oscourse-tsinghua/OS2018spring-projects-g05/doc/out-of-dated/项目总结.pdf

## Tsinghua University

## Computer Organization Experimentation

# Project Summary Document

Author:
Shizhi Tang
Xihang Liu
Zixi Cai

Supervisor:
Yuxiang Zhang
Prof. Weidong Liu

January 21, 2018

## Contents

1 前⾔ | 3
2 迭代开发计划 | 3
3 分⼯ | 4
4 项⽬感想和总结 | 6

## 1 前⾔

本⽂档作为 BnG 组 32-bits MIPS CPU 的项⽬总结。对整个迭代开发的流程和我们在 其中得到的经验进⾏总结。

## 2 迭代开发计划

### 2.1 计划内容

我们组的迭代开发计划如下：

- Sprint 1 代码格式的约定，操作系统解读，分析初步的需求进⽽编写初步的需求⽂ 档，流⽔线通路和基本测试环境的搭建。
- Sprint 2 对应于《⾃⼰动⼿写 CPU》这本书中前 11 章的内容，完成 datapath 和异 常处理的⼯作。
- Sprint 3 串⼜控制器、Flash 访问模块，能够在硬件测试中通过功能测例。
- Sprint 4 能够在硬件上通过监控程序和 u-core。
- Sprint 5 完成 USB、以太⽹、HDMI 的外设⼯作。
- Sprint 6 完成除法等操作，最终可以运⾏ u-boot。

其中需要说明的是，前四个 Sprint 是项⽬的基本要求。⽽第五个和第六个 Sprint 则是 因为我们的进度较好，因此将需求从“能够正常运⾏ ucore”更改为“能够正常运⾏全部的 外设和通过 u-boot 启动 u-core”。可以看到，在这⼀过程⾥，需求是动态变动的。与其他组 不同的是，我们组的特点是：

- ⾸先对项⽬的需求进⾏了分析，并对代码格式和报告的格式进⾏了约定。
- 测试环境的搭建先于代码的编写，我们认为，这也是我们组能够在最后进度最快的重 要原因。
- 硬件测试为多个⼈同时进⾏，⼀⽅⾯是由于代码编译很慢，两个⼈可以在同⼀时间⾥ 验证更多的假设，另⼀⽅⾯，多个⼈ debug 也可以显著提⾼完成硬件测试的速度。

在整个项⽬的进⾏过程中，我们最注重的是测试的充分性。对每⼀个新加⼊的功能， 都需要加⼊对应的单元测试。此外，我们在设计测试框架时，也特别注意了“可以在之后 加⼊新功能之后，通过测例对功能进⾏充分的验证”。基于这⼀思想，我们也对功能测例进 ⾏了定制化。定制化之后的功能测例甚⾄可以直接在 Vivado 的仿真上运⾏，这也避免了实 现所需要花费的巨⼤时间成本，提⾼了 debug 的速度。

### 2.2 计划制定

在⼀开始拿到项⽬之后，我们并没有划分对应的 Sprint。在学期初，我们对 CPU 的整 个运⾏也⼗分不了解。但是我们组每隔⼀周都会开⼀次会，开会的主要内容包含两个⽅⾯：

- 分配下⼀周的任务，在每⼀次开会结束之后，我们会在 gitlab 上发布三个 issue，这 三个 issue 分别对应我们组三名同学在下⼀周所需要完成的⼯作。
- 讨论整个 CPU 中各种难点的设计，如访存时的状态机等。CPU 相关代码的编写⼯ 作，在整个项⽬所占的只是⾮常⼩的⼀部分，⽽合理的设计对项⽬的进⾏有着⾮常好 的帮助，好的架构可以让我们进展更快。此外，通过讨论，我们也可以将单⼈设计犯 错的可能性降低。

在第⼀次⼩组会议上，我们主要完成了代码格式的约定，之后分⼯，由蔡⼦熙同学负 责基本流⽔线的搭建。唐适之同学负责测试环境的搭建，⽽刘熙航则负责需求的分析和初 步需求报告的撰写。在这⼀阶段结束之后，我们⾸先按照《⾃⼰动⼿写 CPU》这本书的章 节顺序进⾏任务的分配（每周三章左右的进度，⼀名同学负责⼀章）。虽然这⼀任务在很多 时候并不能做到完全的并⾏开发，但是这是由于项⽬的特点所致。个⼈认为，我们在并⾏ 上做的是很好的。在按照《⾃⼰动⼿写 CPU》的章节⽬录进⾏项⽬的过程中，我们对整个 项⽬的进度有了更为清晰的认识。因此也就制定了前⽂中的 Sprint 2, 3, 4。按照这样的划 分，Sprint 1 虽然任务量较少，但其对于项⽬的进⾏有着⾄关重要的作⽤。有了好的测试 环境，我们就可以更好的进⾏开发。
由此也可以看到，在项⽬的⼀开始，我们是知道最终⽬标的。但是对于如何达成这⼀ 最终⽬标的认识⼗分不明确。⽽随着项⽬的进⾏，我们对最终⽬标的认识⼀步步的加深。 并在这⼀过程中对项⽬的 Sprint 进⾏了划分。由此我们也意识到，很多任务和我们搭建 mips-32 cpu 都有相似之处：在项⽬的⼀开始，最终的⽬标虽然很明确，但是具体的需求是 模糊的，⽽随着项⽬的进⾏，我们才能完全的明⽩项⽬最终的需求，并按照项⽬的需求进 ⾏变动。在这⼀任务的完成中，敏捷开发的思想是⼗分重要的。只有有了敏捷开发的思想。 我们才能够做得很好。

## 3 分⼯

### 3.1 Sprint 1

对于 Sprint 1，我们的分⼯为：

- 三个⼈⼀起编写代码的⽤例规范。
- 蔡⼦熙负责搭建基本的数据通路。
- 唐适之负责搭建基本的测试框架。
- 刘熙航负责分析需求，撰写初步的需求报告。

### 3.2 Sprint 2

在这⼀部分，分⼯为：

- 蔡⼦熙负责实现了移动指令和算数指令。
- 唐适之负责实现加载存储，并对代码进⾏相关的优化。
- 刘熙航负责实现了逻辑、移位、转移、CP0 和异常指令。

### 3.3 Sprint 3

在这⼀部分，分⼯为：

- 蔡⼦熙负责了串⼜控制器，搭建了功能侧例的仿真框架，并负责了⼀部分功能测例的 仿真通过。
- 唐适之负责实现了 MMU 和 TLB，并在硬件上跑通了全部的功能测例。
- 刘熙航负责对代码进⾏调试，并在仿真中通过了全部的功能测例。

### 3.4 Sprint 4

在这⼀部分，分⼯为：

- 蔡⼦熙和唐适之完成了监控程序的硬件通过。
- 刘熙航和唐适之完成了 u-core 在硬件上的通过（⾄此，基本要求已经完成，我们的 扩展要求分成外设和跑通 u-boot 两部分并⾏完成，即 Sprint5 和 Sprint6 是平⾏关 系）。

### 3.5 Sprint 5

这⼀部分由蔡⼦熙完成。

### 3.6 Sprint 6

这⼀部分的分⼯为：

- 蔡⼦熙实现了除法指令，并在硬件上跑通了全部的功能测例。
- 唐适之同学实现了额外的访存指令，并负责了 u-boot 相关的⼀些 debug。
- 刘熙航同学实现了与 cp0 相关的额外指令。

3.7 ⽂档

这⼀部分的分⼯为：唐适之负责设计⽂档，蔡⼦熙负责测试⽂档，刘熙航负责完善之 前的需求⽂档，并补充项⽬的总结⽂档。

## 4 项⽬感想和总结

我们的项⽬获得了巨⼤的成功，在计原最终展⽰时，我们组是所有的组⾥唯⼀⼀组跑通 u-boot 和全部功能测例的组，并且也实现了全部的可能实现的外设，可以说，我们完美的完 成了学期初的需求。以下，我们将项⽬开发中的⼀些经验和对项⽬的感想、建议总结如下：

### 4.1 项⽬总结

我们将在项⽬中收获的经验和整个开发流程的感受总结如下： 虽然在前期，我们组的进度与其他组很接近，但是到了后期，从跑通监控程序开始， 我们组的进度就已经领先了所有其他组。不得不说，整个实验的环境也有⼀些坑，这些 坑中的很多也都是要靠我们组慢慢的填平。如功能测例中的两个 bug:访存破坏⾃⾝数据 区、将 Cache 指令作为 reserved instruction，包括 u-core 会在不会被执⾏到的函数中使⽤ break 和 div 这两条指令，这些问题也都是我们组第⼀个遇到的。可以说，我们在这些坑上 花费了很多时间，但这些时间也是这个项⽬的⼀部分。就⼯作量⽽⾔，我们认为，⾃⼰的 32 位 CPU 并不⽐ 16 位的 CPU 复杂，需要的可能仅仅是将三周的时间平摊到⼀个学期， ⼤多数时间的⼯作量也反⽽会更少。所以，32 位 CPU 的实验，虽然有⼀些待完善的地⽅， 但也是⾮常值得去选的。
关于测试：
我们的测试分成三个阶段：在⼀开始，采⽤我们⾃⾏编写的测试框架进⾏单元测试， 之后通过功能测例进⾏集成测试，然后通过监控程序进⾏测试和 debug，之后通过 ucore 和 uboot 进⾏ debug。实际上，监控程序、ucore、uboot 除了需要⽀持的指令和机制有少 许的差别外，更⼤的难度来⾃于代码的规模。因为很多的 bug 会在⼀些概率极低的情况出 现（如我们曾经发现，sw 在 jalr 后三条时会出 bug，这就是⼀个很⼩概率的事件，但是却 直到 uboot 阶段才触发）。
测试⼀定要尽量早做，尽量全⾯地去做，我们的测试分为单元测试和集成测试两个部 分，集成测试又分为软件和硬件。在跑 u-core 时，我们耗时最长的⼀个 bug 花费了⼤约 70 个⼩时才被解决，⽽原因是在单元测试时，由于测试过于复杂⽽忽视了 ASID 段的相关内 容。在完成这个项⽬的过程⾥，我们真真切切感受到了，debug 的难度和项⽬的复杂程度 成指数级的关系。所以，单元测试⼀定要尽量全⾯的覆盖所有情况。这样可以为后期减少 很多的⿇烦。
在不同的测试阶段，应当关注不同的问题，在单元测试时，我们只需要去观察对应的 单元执⾏结果是否正确，⽽对于集成测试，我们更关注的是多条语句的结合。在硬件测试 时，问题往往是由访存等耗时较长的操作产⽣的，⽽在最终跑 u-core 和 u-boot 的阶段，⼤ 多数的 bug 都是和 cp0 相关的机制导致的，这些机制之前很难通过单元测试和功能测例找 到。特别是，很多情况下 bug 的发⽣会有条件，⽐如我们之前曾经发现，sw 在 jalr 之后三

条的位置会出错。这些也很难通过集成测试来查找。
我们认为，功能测例并不⾜以算是集成测试，其更偏向于单元测试（这是因为其测试 的重点在于指令是否按照期望被执⾏，⽽不是能通过指令的组合起到某些效果）。因为对于 硬件⽽⾔，集成测试的环境其实是很难编写的，其难度可能⽐ debug 还⾼，所以我们并没 有花时间去编写相应的框架。
关于设计：
虽然我们的编程是基于 VHDL 和 Verilog HDL 的，这也意味着和传统的设计模式没有 ⼤的关联，但是设计仍然很重要。这⾥所指的设计是整个流⽔线通路的设计。例如，在 《⾃⼰动⼿写 CPU》这本书中，其异常所采⽤的⽅法是⼀个向量的每⼀个 bit 代表⼀种异 常。⽽我们就将其修改为了⼀个 5bit 的数据来记录异常。这些与 mips 标准不太符合的修 改，是基于整个项⽬的特征所进⾏的。因此，对需求进⾏更全⾯、更充分的分析，可以让 我们在设计通路时少⾛很多弯路，进⽽达到提⾼效率的⽬的
关于分⼯：
⼤多数时候，我们的项⽬是串⾏⼯作的，这也是项⽬的性质所致：流⽔线通路的搭建， 往往是⼀个功能需要建⽴在前⼀个功能已经完整实现的基础之上。针对这⼀情况，我们采 ⽤了以下⼏种⽅式来缓解这⼀问题：
- 我们将每个⼈每周的空余时间分开，例如 A 在周三到周五完成功能 A，B 在周六开 始完成依赖于功能 A 的功能 B，以此类推。
- 在硬件测试时，由多个⼈同时找 bug，通过交流来提⾼效率。

### 4.2 项⽬感想

32 位 mips CPU 的项⽬，可以让我们更熟悉计算机的相关知识，熟悉 c++ 编译器可 能⽣成的所有指令的⼯作原理。虽然我们以后可能不会在 mips 架构上⼯作，但是熟悉底层 仍然可以帮助我们写出更好、更快的代码。⽽这些，也正是我们作为计算机科班学⽣的核 ⼼竞争⼒所在。⽽且，32 位的 CPU，让我们对底层的架构有了更为清晰的认知。 在下⼀学期⾥，我们将继续这⼀项⽬，与操作系统课联合，希望可以在 2018 年 9 ⽉龙 芯的⽐赛⾥取得好成绩。

### 4.3 对学弟学妹们的建议

我们的建议有以下⼏点：

- 要让团队中的每个成员都熟悉别⼈做的事情，熟悉所需要⽤到的全部⼯具链。
- 要尽早开始对项⽬进⾏测试。
- 开发流程中，要约定代码规范，实现功能时要考虑到后续被扩展的可能。
- 在项⽬中的⼀些难点上，要多与队友进⾏讨论。

BnG, better and greater.
