oscourse-tsinghua/OS2018spring-projects-g05/(threads)

Thread 3 (2018-03-31):

确认下述指令的实际含义，并实现

roastduck, 2018-03-31:
通过`mipsel-linux-gnu-objdump -d vmlinux | less`可以发现下述未能辨别的指令。请手动翻译机器码，确认其实际对应的指令，并实现

```
bc0t
bc0fl
c0
ehb
jr.hb
cfc0
ldc3
negu
sdc3
```

XemboLiu, 2018-04-03:
最新版本的指令集见：https://www.mips.com/?do-download=the-mips32-instruction-set-v6-06

bc0t：未能找到满足高12位可能是0x410的指令
bc0fl：未能找到满足高12位可能是0x410的指令
c0 0x4：这条指令实际上是 TLBINVF
ehb：有这条指令
jr.hb：有这条指令
cfc0 mfhc0：直接返回0即可（注：release6之前未定义，release6的文档中要求其将相应的寄存器置0）
ldc3：没有找到”110111”开头的指令
negu：实际上是特殊的subu指令
sdc3：未找到二进制为”111111”开头的指令

Thread 5 (2018-03-31):

编译使用软浮点数的Linux

roastduck, 2018-03-31:
Linux选项中`MATH_EMULATION`不适用于MIPS，但`mipsel-linux-gnu-`交叉编译器可以通过`-msoft-float`的方法编译软浮点数。请确认Linux是否有其他方式打开软浮点数，或修改Linux的Makefile以编译软浮点数。

roastduck, 2018-04-01:
根据[这篇文章](https://www.linux-mips.org/wiki/Floating_point)所述，不需要专门编译使用软浮点数的Linux。Linux会根据unimplemented异常自动处理。

Closed 2018-04-01.

Thread 6 (2018-04-01):

注意：Vivado综合器/仿真器在处理process(all)时可能忽略某些复杂类型的敏感信号

roastduck, 2018-04-01:
```
-- Probe entry
-- Here might be some bugs with the synthesisier, which failed to work with `process(all)`
process (entries, entry_i) begin
    index_o <= 4x"0";
    indexValid_o <= '0';
    for i in 0 to TLB_ENTRY_NUM - 1 loop
        if (entries(i).hi(EntryHiVPN2Bits) = entry_i.hi(EntryHiVPN2Bits)) then
            if (
                (entries(i).lo0(ENTRY_LO_G_BIT) and entries(i).lo1(ENTRY_LO_G_BIT)) = '1' or -- global
                entries(i).hi(EntryHiASIDBits) = entry_i.hi(EntryHiASIDBits) -- ASID match
            ) then
                index_o <= conv_std_logic_vector(i, 4);
                indexValid_o <= '1';
            end if;
        end if;
    end loop;
end process;
```

以上代码无法使用`process(all)`正常工作。

Thread 17 (2018-04-13):

关于Vivado Implement阶段卡死的注意事项

roastduck, 2018-04-13:
如果发现Vivado运行到某一阶段一直不能结束，但CPU利用率很低，很可能相关进程已经死了，这可以在log里确认。如果出现这种情况，可以考虑更改Implement策略。各策略的介绍见[文档UG904](https://www.xilinx.com/support/documentation/sw_manuals/xilinx2016_1/ug904-vivado-implementation.pdf)的附录C

roastduck, 2018-04-14:
如果怀疑遇到了时序冲突（例如遇到了随机错误），应选用优化更好的Synthesis/Implement策略

Thread 22 (2018-05-06):

项目中存在时序约束违例

roastduck, 2018-05-06:
现在从输入的100MHz的时钟生成25MHz的时钟，相位偏移了67°，最大的slack还有零点几纳秒，并且还可能有25MHz时钟域信号建立时间不足的隐患。

违例出现在`ddr3_ctrl`中，最严重的路径是从`busy_res`到`stat25`的。由于`stat25`是状态寄存器，所以不知道要怎么修改。不过，目的地是`readData_o`或`busy_o`的跨时钟域路径不必在意，因为它们实际上一个半周期算完就行，而不是半个周期。

roastduck, 2018-05-27:
此违例在DDR3测试中存在，但在主SoC中不存在。

Closed 2018-05-27.

Thread 53 (2018-09-12):

与FPU有关的TODO

XemboLiu, 2018-09-12:
add.d
bc1f
bc1t
c.eq.d
c.lt.d
c.ule.d
c.un.d
div.d
mov.d
mul.d
mul.s
sqrt.d
trunc.w.d

XemboLiu, 2018-09-12:
sub.d

XemboLiu, 2018-09-12:
总计三类：
- bc1f, bc1t与c.cond.fmt六条指令，类似于ll和sc的关系
- add.d sub.d mul.d/ mul.s div.d sqrt.d 六条计算指令
- trunc.w.d mov.d处理浮点寄存器，可以视为较为简单的计算指令
主体工作ddl暂定为周六
