oscourse-tsinghua/OS2018spring-projects-g05/myCPU/top.vhd

library ieee;
use ieee.std_logic_1164.all;
use work.global_const.all;
use work.bus_const.all;

entity top is
    generic (
        FUNC_TEST, MONITOR, USE_BOOTLOADER, ENABLE_CPU2: integer -- Only integer is supported in top level
    );
    port (
        clk_in: in std_logic; -- 100MHz clock input
        rst_n: in std_logic; -- Reset

        led_n: out std_logic_vector(15 downto 0); -- Single color LED
        led_rg0, led_rg1: out std_logic_vector(1 downto 0); -- Dual color LED

        num_cs_n: out std_logic_vector(7 downto 0); -- 7-seg enable
        num_a_g: out std_logic_vector(6 downto 0); -- 7-seg data

        switch: in std_logic_vector(7 downto 0); -- Switches. Push up for 0 and pull down for 1
        btn_key_col, btn_key_row: in std_logic_vector(3 downto 0); -- Keypad
        btn_step: in std_logic_vector(1 downto 0); -- Pulse button

        -- SPI flash EN25F80
        spi_clk: out std_logic; -- clock
        spi_cs_n: out std_logic; -- enable
        spi_di: out std_logic; -- data CPU -> flash
        spi_do: in std_logic; -- data flash -> CPU

        -- Ethernet DM9161AEP
        eth_txclk: in std_logic; -- Transmit reference clock
        eth_rxclk: in std_logic; -- Receive reference clock
        eth_txen: out std_logic; -- Transmit enable
        eth_txd: out std_logic_vector(3 downto 0); -- Transmit data
        eth_txerr: out std_logic; -- Transmit error
        eth_rxdv: in std_logic; -- Receive valid
        eth_rxd: in std_logic_vector(3 downto 0); -- Receive data
        eth_rxerr: in std_logic; -- Receive error
        eth_coll: in std_logic; -- Collision
        eth_crs: in std_logic; -- Carrier sence detect
        eth_mdc: out std_logic; -- Management data clock
        eth_mdio: inout std_logic; -- Management data I/O
        eth_rst_n: out std_logic; -- Reset

        -- UART
        uart_rx: in std_logic; -- Receive
        uart_tx: out std_logic; -- Transmit

        -- DDR3
        ddr3_dq: inout std_logic_vector(15 downto 0);
        ddr3_addr: out std_logic_vector(12 downto 0);
        ddr3_ba: out std_logic_vector(2 downto 0);
        ddr3_ras_n: out std_logic;
        ddr3_cas_n: out std_logic;
        ddr3_we_n: out std_logic;
        ddr3_odt: out std_logic;
        ddr3_reset_n: out std_logic;
        ddr3_cke: out std_logic;
        ddr3_dm: out std_logic_vector(1 downto 0);
        ddr3_dqs_p: inout std_logic_vector(1 downto 0);
        ddr3_dqs_n: inout std_logic_vector(1 downto 0);
        ddr3_ck_p: out std_logic;
        ddr3_ck_n: out std_logic
    );
end top;

architecture bhv of top is
    function getExceptBootBaseAddr return std_logic_vector is begin
        if (FUNC_TEST = 1 or MONITOR = 1) then
            return 32ux"80000000";
        else
            return 32ux"bfc00200";
        end if;
    end getExceptBootBaseAddr;
    function getTlbRefillExl0Offset return std_logic_vector is begin
        if (FUNC_TEST = 1) then
            return 32ux"180";
        elsif (MONITOR = 1) then
            return 32ux"1000";
        else
            return 32ux"000";
        end if;
    end getTlbRefillExl0Offset;
    function getGeneralExceptOffset return std_logic_vector is begin
        if (MONITOR = 1) then
            return 32ux"1180";
        else
            return 32ux"180";
        end if;
    end getGeneralExceptOffset;
    function getInstEntranceAddr return std_logic_vector is begin
        if (USE_BOOTLOADER = 1) then
            return 32ux"bfc00000";
        else
            return 32ux"80000000";
        end if;
    end getInstEntranceAddr;
    function cpu2On return std_logic is begin
        if (ENABLE_CPU2 = 1) then
            return '1';
        else
            return '0';
        end if;
    end cpu2On;

    -- Verilog entities must be declared
    component clk_wiz
        port (
            clk_in1: in std_logic;
            clk_out1, clk_out2, clk_out3: out std_logic
        );
    end component;
    component async_transmitter
        generic (
            ClkFrequency, Baud: integer
        );
        port (
            clk, TxD_start: in std_logic;
            TxD_data: in std_logic_vector(7 downto 0);
            TxD, TxD_busy: out std_logic
        );
    end component;
    component async_receiver
        generic (
            ClkFrequency, Baud: integer;
            Oversampling: integer := 8
        );
        port (
            clk, RxD: in std_logic;
            RxD_data_ready: out std_logic;
            RxD_data: out std_logic_vector(7 downto 0);
            RxD_idle, RxD_endofpacket: out std_logic
        );
    end component;

    signal rst: std_logic;

    signal clkMain: std_logic; -- 25MHz clock
    signal clk200, clk100: std_logic;

    signal cpu1Inst_c2d, cpu1Data_c2d, cpu2Inst_c2d, cpu2Data_c2d: BusC2D;
    signal cpu1Inst_d2c, cpu1Data_d2c, cpu2Inst_d2c, cpu2Data_d2c: BusD2C;
    signal ddr3_c2d, flash_c2d, serial_c2d, boot_c2d, eth_c2d, led_c2d, num_c2d, ipi_c2d, intc_c2d: BusC2D;
    signal ddr3_d2c, flash_d2c, serial_d2c, boot_d2c, eth_d2c, led_d2c, num_d2c, ipi_d2c, intc_d2c: BusD2C;

    signal busMon: BusC2D;
    signal llBit: std_logic;
    signal llLoc: std_logic_vector(AddrWidth);

    signal scCorrect1, scCorrect2: std_logic;
    signal sync1, sync2: std_logic_vector(2 downto 0);
    signal irq1, irq2: std_logic_vector(5 downto 0);
    signal timerInt1, timerInt2, comInt, usbInt, ethInt, ethIrq: std_logic;
    signal ipiInt: std_logic_vector(1 downto 0);

    -- Serial COM
    signal rxdReady, txdBusy, txdStart: std_logic;
    signal rxdData, txdData: std_logic_vector(7 downto 0);

    -- Ethernet
    signal eth_mdio_i, eth_mdio_o, eth_mdio_t: std_logic;

    -- LED
    signal ledHold: std_logic_vector(15 downto 0);
begin
    rst <= not rst_n;

    clk_wiz_ist: clk_wiz
        port map (
            clk_in1 => clk_in,
            clk_out1 => clk200,
            clk_out2 => clkMain,
            clk_out3 => clk100
        );

    uart_r: async_receiver
        generic map (
            ClkFrequency => 25000000,
            Baud => 9600
        )
        port map (
            clk => clkMain,
            RxD => uart_rx,
            RxD_data_ready => rxdReady,
            RxD_data => rxdData
        );
    uart_t: async_transmitter
        generic map (
            ClkFrequency => 25000000,
            Baud => 9600
        )
        port map (
            clk => clkMain,
            TxD => uart_tx,
            TxD_busy => txdBusy,
            TxD_start => txdStart,
            TxD_data => txdData
        );

    irq1 <= (5 => timerInt1, 4 => ipiInt(0), 3 => ethInt, 2 => comInt, others => '0');
    irq2 <= (5 => timerInt2, 4 => ipiInt(1), 3 => ethInt, 2 => comInt, others => '0');
    -- MIPS standard requires irq[5] = timer
    -- Monitor requires irq[2] = COM
    -- The IRQ ID should be consistent with the .dts file in Linux

    cpu1_ist: entity work.cpu
        generic map (
            memPushForward => true, -- TODO: Why???
            exceptBootBaseAddr => getExceptBootBaseAddr,
            tlbRefillExl0Offset => getTlbRefillExl0Offset,
            generalExceptOffset => getGeneralExceptOffset,
            instEntranceAddr => getInstEntranceAddr,
            cpuId => (0 => CPU1_ID, others => '0'),
            scStallPeriods => 0
        )
        port map (
            clk => clkMain,
            rst => rst,
            instDev_i => cpu1Inst_d2c,
            dataDev_i => cpu1Data_d2c,
            instDev_o => cpu1Inst_c2d,
            dataDev_o => cpu1Data_c2d,
            busMon_i => busMon,
            llBit_i => llBit,
            llLoc_i => llLoc,
            sync_o => sync1,
            scCorrect_i => scCorrect1,
            int_i => irq1,
            timerInt_o => timerInt1,
            debug_wb_pc => open,
            debug_wb_rf_wen => open,
            debug_wb_rf_wnum => open,
            debug_wb_rf_wdata => open
        );

    cpu2_ist: entity work.cpu
        generic map (
            memPushForward => true,
            exceptBootBaseAddr => getExceptBootBaseAddr,
            tlbRefillExl0Offset => getTlbRefillExl0Offset,
            generalExceptOffset => getGeneralExceptOffset,
            instEntranceAddr => getInstEntranceAddr,
            cpuId => (0 => CPU2_ID, others => '0'),
            scStallPeriods => 63
        )
        port map (
            clk => clkMain,
            rst => rst or not cpu2On,
            instDev_i => cpu2Inst_d2c,
            dataDev_i => cpu2Data_d2c,
            instDev_o => cpu2Inst_c2d,
            dataDev_o => cpu2Data_c2d,
            busMon_i => busMon,
            llBit_i => llBit,
            llLoc_i => llLoc,
            sync_o => sync2,
            scCorrect_i => scCorrect2,
            int_i => irq2,
            timerInt_o => timerInt2,
            debug_wb_pc => open,
            debug_wb_rf_wen => open,
            debug_wb_rf_wnum => open,
            debug_wb_rf_wdata => open
        );

    devctrl_ist: entity work.devctrl
        port map (
            clk => clkMain,
            rst => rst,

            cpu1Inst_i => cpu1Inst_c2d,
            cpu1Data_i => cpu1Data_c2d,
            cpu1Inst_o => cpu1Inst_d2c,
            cpu1Data_o => cpu1Data_d2c,
            cpu2Inst_i => cpu2Inst_c2d,
            cpu2Data_i => cpu2Data_c2d,
            cpu2Inst_o => cpu2Inst_d2c,
            cpu2Data_o => cpu2Data_d2c,

            ddr3_i => ddr3_d2c,
            flash_i => flash_d2c,
            serial_i => serial_d2c,
            boot_i => boot_d2c,
            eth_i => eth_d2c,
            led_i => led_d2c,
            num_i => num_d2c,
            ipi_i => ipi_d2c,
            intc_i => intc_d2c,
            ddr3_o => ddr3_c2d,
            flash_o => flash_c2d,
            serial_o => serial_c2d,
            boot_o => boot_c2d,
            eth_o => eth_c2d,
            led_o => led_c2d,
            num_o => num_c2d,
            ipi_o => ipi_c2d,
            intc_o => intc_c2d,

            busMon_o => busMon,
            llBit_o => llBit,
            llLoc_o => llLoc,

            sync1_i => sync1,
            scCorrect1_o => scCorrect1,
            sync2_i => sync2,
            scCorrect2_o => scCorrect2
    );

    -- Please don't pass tri-state ports into a sub-module

    flash_ctrl_ist: entity work.flash_ctrl
        port map (
            clk => clkMain,
            rst => rst,
            cpu_i => flash_c2d,
            cpu_o => flash_d2c,
            clk_o => spi_clk,
            cs_n_o => spi_cs_n,
            di_o => spi_di,
            do_i => spi_do
        );

    ddr3_ctrl_encap_ist: entity work.ddr3_ctrl_encap
        port map (
            clk_100 => clk100,
            clk_200 => clk200,
            clk_25 => clkMain,
            rst => rst,

            cpu_i => ddr3_c2d,
            cpu_o => ddr3_d2c,

            ddr3_dq => ddr3_dq,
            ddr3_addr => ddr3_addr,
            ddr3_ba => ddr3_ba,
            ddr3_ras_n => ddr3_ras_n,
            ddr3_cas_n => ddr3_cas_n,
            ddr3_we_n => ddr3_we_n,
            ddr3_odt => ddr3_odt,
            ddr3_reset_n => ddr3_reset_n,
            ddr3_cke => ddr3_cke,
            ddr3_dm => ddr3_dm,
            ddr3_dqs_p => ddr3_dqs_p,
            ddr3_dqs_n => ddr3_dqs_n,
            ddr3_ck_p => ddr3_ck_p,
            ddr3_ck_n => ddr3_ck_n
        );

    serial_ctrl_ist: entity work.serial_ctrl
        port map (
            clk => clkMain,
            rst => rst,
            cpu_i => serial_c2d,
            cpu_o => serial_d2c,
            int_o => comInt,
            rxdReady_i => rxdReady,
            rxdData_i => rxdData,
            txdBusy_i => txdBusy,
            txdStart_o => txdStart,
            txdData_o => txdData
        );

    boot_ctrl_ist: entity work.boot_ctrl
        port map (
            cpu_i => boot_c2d,
            cpu_o => boot_d2c
        );

    eth_ctrl_encap_ist: entity work.eth_ctrl_encap
        port map (
            clk_100 => clk100,
            clk_25 => clkMain,
            rst => rst,

            cpu_i => eth_c2d,
            cpu_o => eth_d2c,

            eth_rst_n => eth_rst_n,
            eth_txclk => eth_txclk,
            eth_rxclk => eth_rxclk,
            eth_txen => eth_txen,
            eth_rxdv => eth_rxdv,
            eth_txerr => eth_txerr,
            eth_rxerr => eth_rxerr,
            eth_txd => eth_txd,
            eth_rxd => eth_rxd,
            eth_coll => eth_coll,
            eth_crs => eth_crs,
            eth_mdio_i => eth_mdio_i,
            eth_mdio_o => eth_mdio_o,
            eth_mdio_t => eth_mdio_t,
            eth_mdc => eth_mdc,
            int_o => ethIrq
        );
    eth_mdio <= 'Z' when eth_mdio_t = '1' else eth_mdio_o;
    eth_mdio_i <= eth_mdio;

    int_ctrl_encap_ist: entity work.int_ctrl_encap
        port map (
            clk_100 => clk100,
            clk_25 => clkMain,
            rst => rst,

            cpu_i => intc_c2d,
            cpu_o => intc_d2c,

            int_i => ethIrq,
            int_o => ethInt
        );

    seg7_ctrl_ist: entity work.seg7_ctrl
        port map (
            clk => clkMain,
            rst => rst,
            cpu_i => num_c2d,
            cpu_o => num_d2c,
            cs_n_o => num_cs_n,
            lights_o => num_a_g
        );

    led_d2c.busy <= PIPELINE_NONSTOP;
    led_d2c.dataLoad <= (others => 'X');
    led_n <= not ledHold;
    process (clkMain) begin
        if (rising_edge(clkMain)) then
            if (rst = '1') then
                ledHold <= (others => '0');
            elsif (led_c2d.enable = '1') then
                ledHold <= led_c2d.dataSave(15 downto 0);
            end if;
        end if;
    end process;

    ipi_ctrl_ist: entity work.ipi_ctrl
        port map (
            clk => clkMain,
            rst => rst,
            cpu_i => ipi_c2d,
            cpu_o => ipi_d2c,
            int_o => ipiInt
        );
end bhv;
