oscourse-tsinghua/OS2018spring-projects-g05/src/thinpad_top.v

`default_nettype none

module thinpad_top(/*autoport*/
//inout
         base_ram_data,
         ext_ram_data,
         flash_data,
         sl811_data,
         dm9k_data,
//output
         uart_rdn,
         uart_wrn,
         base_ram_addr,
         base_ram_be_n,
         base_ram_ce_n,
         base_ram_oe_n,
         base_ram_we_n,
         ext_ram_addr,
         ext_ram_be_n,
         ext_ram_ce_n,
         ext_ram_oe_n,
         ext_ram_we_n,
         txd,
         flash_a,
         flash_rp_n,
         flash_vpen,
         flash_oe_n,
         flash_ce_n,
         flash_byte_n,
         flash_we_n,
         sl811_a0,
         sl811_we_n,
         sl811_rd_n,
         sl811_cs_n,
         sl811_rst_n,
         sl811_dack,
         dm9k_cmd,
         dm9k_we_n,
         dm9k_rd_n,
         dm9k_cs_n,
         dm9k_rst_n,
         leds,
         video_pixel,
         video_hsync,
         video_vsync,
         video_clk,
         video_de,
//input
         clk_in,
         clk_uart_in,
         uart_dataready,
         uart_tbre,
         uart_tsre,
         rxd,
         sl811_int,
         sl811_drq,
         dm9k_int,
         dip_sw,
         touch_btn);


input wire clk_in; //50MHz main clock input
input wire clk_uart_in; //11.0592MHz clock for UART

//UART controller signals
output wire uart_rdn;
output wire uart_wrn;
input wire uart_dataready;
input wire uart_tbre;
input wire uart_tsre;

//Base memory signals, a.k.a. RAM1
inout wire[31:0] base_ram_data; // [7:0] also connected to CPLD
output wire[19:0] base_ram_addr;
output wire[3:0] base_ram_be_n;
output wire base_ram_ce_n;
output wire base_ram_oe_n;
output wire base_ram_we_n;
//assign base_ram_be_n=4'b0; // keep ByteEnable zero if you don't know what it is

//Extension memory signals
inout wire[31:0] ext_ram_data;
output wire[19:0] ext_ram_addr;
output wire[3:0] ext_ram_be_n;
output wire ext_ram_ce_n;
output wire ext_ram_oe_n;
output wire ext_ram_we_n;
//assign ext_ram_be_n=4'b0; // keep ByteEnable zero if you don't know what it is

//Ext serial port signals
output wire txd;
input wire rxd;

//Flash memory, JS28F640
output wire [22:0]flash_a;
output wire flash_rp_n;
output wire flash_vpen;
output wire flash_oe_n;
inout wire [15:0]flash_data;
output wire flash_ce_n;
output wire flash_byte_n;
output wire flash_we_n;

//SL811 USB controller signals
output wire sl811_a0;
inout wire[7:0] sl811_data;
output wire sl811_we_n;
output wire sl811_rd_n;
output wire sl811_cs_n;
output wire sl811_rst_n;
output wire sl811_dack;
input wire sl811_int;
input wire sl811_drq;

//DM9000 Ethernet controller signals
output wire dm9k_cmd;
inout wire[15:0] dm9k_data;
output wire dm9k_we_n;
output wire dm9k_rd_n;
output wire dm9k_cs_n;
output wire dm9k_rst_n;
input wire dm9k_int;

//LED, SegDisp, DIP SW, and BTN1~6
output wire[31:0] leds; // leds[31:16] is SegDisp, leds[15:0] is LEDs
input wire[31:0] dip_sw;
input wire[5:0] touch_btn;

//Video output
output wire[7:0] video_pixel;
output wire video_hsync;
output wire video_vsync;
output wire video_clk;
output wire video_de;

/* =========== END OF PORT DECLARATION ============= */

wire rst;
assign rst = touch_btn[5];

wire clk25; // 25MHz clock
clk_ctrl clk_ctrl_ist(
    .clk_in1(clk_in),
    .clk_out1(clk25)
);

// 7-Segment display decoder
reg[7:0] numberHold;
SEG7_LUT segL(.oSEG1({leds[23:22],leds[19:17],leds[20],leds[21],leds[16]}), .iDIG(numberHold[3:0]));
SEG7_LUT segH(.oSEG1({leds[31:30],leds[27:25],leds[28],leds[29],leds[24]}), .iDIG(numberHold[7:4]));

// LED
reg[15:0] ledHold;
assign leds[15:0] = ledHold;

// Serial COM
wire rxdReady, txdBusy, txdStart;
wire[7:0] rxdData, txdData;
async_receiver
    #(.ClkFrequency(25000000), .Baud(9600))
    uart_r(.clk(clk25), .RxD(rxd), .RxD_data_ready(rxdReady), .RxD_data(rxdData));
async_transmitter
    #(.ClkFrequency(25000000),.Baud(9600))
    uart_t(.clk(clk25), .TxD(txd), .TxD_busy(txdBusy), .TxD_start(txdStart), .TxD_data(txdData));

wire devEnable, devWrite, devBusy;
wire[31:0] dataSave, dataLoad, addr;
wire[3:0] byteSelect;
wire[5:0] int;
wire timerInt, comInt, usbInt, ethInt;
assign int = {timerInt, 1'b0, 1'b0, comInt, ethInt, usbInt};
// NOTE: 1'b0 cannot be written as 0
// MIPS standard requires int[5] = timer
// Monitor requires int[2] = COM

cpu #(
`ifdef FUNC_TEST
    .exceptBootBaseAddr(32'h80000000),
    .tlbRefillExl0Offset(32'h180),
`elsif MONITOR
    .exceptBootBaseAddr(32'h80000000),
    .tlbRefillExl0Offset(32'h1000),
    .generalExceptOffset(32'h1180),
`endif
`ifdef USE_BOOTLOADER
    .instEntranceAddr(32'hbfc00000)
`else
    .instEntranceAddr(32'h80000000)
`endif
) cpu_ist (
    .clk(clk25),
    .rst(rst),
    .devEnable_o(devEnable),
    .devWrite_o(devWrite),
    .devBusy_i(devBusy),
    .devDataSave_o(dataSave),
    .devDataLoad_i(dataLoad),
    .devPhysicalAddr_o(addr),
    .devByteSelect_o(byteSelect),
    .int_i(int),
    .timerInt_o(timerInt)
);

wire ram0Enable, ram0ReadEnable, ram0WriteBusy;
wire[31:0] ram0DataSave, ram0DataLoad;
wire ram1Enable, ram1ReadEnable, ram1WriteBusy;
wire[31:0] ram1DataSave, ram1DataLoad;

wire flashEnable, flashReadEnable, flashBusy;
wire[31:0] flashDataLoad;

wire vgaEnable, vgaWriteEnable;
wire[31:0] vgaWriteData;
assign video_clk = clk25;

wire ltcEnable, ltcReadEnable, ltcBusy;
wire[31:0] ltcDataLoad;

wire comEnable, comReadEnable;
wire[31:0] comDataSave, comDataLoad;

wire usbEnable, usbReadEnable, usbWriteEnable, usbBusy;
wire[31:0] usbReadData, usbWriteData;

wire ethEnable, ethReadEnable, ethWriteBusy;
wire[31:0] ethDataLoad, ethDataSave;

wire[31:0] bootDataLoad;

wire ledEnable, numEnable;
wire[15:0] ledData;
wire[7:0] numData;

devctrl devctrl_ist(
    .devEnable_i(devEnable),
    .devWrite_i(devWrite),
    .devBusy_o(devBusy),
    .devDataSave_i(dataSave),
    .devDataLoad_o(dataLoad),
    .devPhysicalAddr_i(addr),

    .ram0Enable_o(ram0Enable),
    .ram0ReadEnable_o(ram0ReadEnable),
    .ram0DataSave_o(ram0DataSave),
    .ram0DataLoad_i(ram0DataLoad),
    .ram0WriteBusy_i(ram0WriteBusy),
    .ram1Enable_o(ram1Enable),
    .ram1ReadEnable_o(ram1ReadEnable),
    .ram1DataSave_o(ram1DataSave),
    .ram1DataLoad_i(ram1DataLoad),
    .ram1WriteBusy_i(ram1WriteBusy),

    .flashEnable_o(flashEnable),
    .flashReadEnable_o(flashReadEnable),
    .flashDataLoad_i(flashDataLoad),
    .flashBusy_i(flashBusy),

    .vgaEnable_o(vgaEnable),
    .vgaWriteEnable_o(vgaWriteEnable),
    .vgaWriteData_o(vgaWriteData),

    .comEnable_o(comEnable),
    .comReadEnable_o(comReadEnable),
    .comDataSave_o(comDataSave),
    .comDataLoad_i(comDataLoad),

    .usbEnable_o(usbEnable),
    .usbReadEnable_o(usbReadEnable),
    .usbReadData_i(usbReadData),
    .usbWriteEnable_o(usbWriteEnable),
    .usbWriteData_o(usbWriteData),
    .usbBusy_i(usbBusy),

    .bootDataLoad_i(bootDataLoad),

    .ltcEnable_o(ltcEnable),
    .ltcReadEnable_o(ltcReadEnable),
    .ltcDataLoad_i(ltcDataLoad),
    .ltcBusy_i(ltcBusy),

    .ethEnable_o(ethEnable),
    .ethReadEnable_o(ethReadEnable),
    .ethDataLoad_i(ethDataLoad),
    .ethDataSave_o(ethDataSave),
    .ethWriteBusy_i(ethWriteBusy),

    .ledEnable_o(ledEnable),
    .ledData_o(ledData),
    .numEnable_o(numEnable),
    .numData_o(numData)
);

// Please don't pass inout port into a sub-module
wire ram0TriStateWrite;
sram_ctrl base_sram_ctrl(
    .clk(clk25),
    .rst(rst),
    .enable_i(ram0Enable),
    .readEnable_i(ram0ReadEnable),
    .addr_i(addr),
    .byteSelect_i(byteSelect),
    .busy_o(ram0WriteBusy),
    .triStateWrite_o(ram0TriStateWrite),
    .addr_o(base_ram_addr),
    .be_n_o(base_ram_be_n),
    .ce_n_o(base_ram_ce_n),
    .oe_n_o(base_ram_oe_n),
    .we_n_o(base_ram_we_n)
);
assign base_ram_data = ram0TriStateWrite ? ram0DataSave : 32'hzzzzzzzz;
assign ram0DataLoad = base_ram_data;

wire ram1TriStateWrite;
sram_ctrl ext_sram_ctrl(
    .clk(clk25),
    .rst(rst),
    .enable_i(ram1Enable),
    .readEnable_i(ram1ReadEnable),
    .addr_i(addr),
    .byteSelect_i(byteSelect),
    .busy_o(ram1WriteBusy),
    .triStateWrite_o(ram1TriStateWrite),
    .addr_o(ext_ram_addr),
    .be_n_o(ext_ram_be_n),
    .ce_n_o(ext_ram_ce_n),
    .oe_n_o(ext_ram_oe_n),
    .we_n_o(ext_ram_we_n)
);
assign ext_ram_data = ram1TriStateWrite ? ram1DataSave : 32'hzzzzzzzz;
assign ram1DataLoad = ext_ram_data;

flash_ctrl flash_ctrl_ist(
    .clk(clk25),
    .rst(rst),
    .devEnable_i(flashEnable),
    .addr_i(addr),
    .readEnable_i(flashReadEnable),
    .readData_o(flashDataLoad),
    .busy_o(flashBusy),
    .flRst_o(flash_rp_n),
    .flOE_o(flash_oe_n),
    .flCE_o(flash_ce_n),
    .flWE_o(flash_we_n),
    .flAddr_o(flash_a),
    .flData_i(flash_data),
    .flByte_o(flash_byte_n),
    .flVpen_o(flash_vpen)
);

vga_ctrl vga_ctrl_ist(
    .clk(clk25),
    .rst(rst),
    .devEnable_i(vgaEnable),
    .addr_i(addr),
    .writeEnable_i(vgaWriteEnable),
    .writeData_i(vgaWriteData),
    .writeByteSelect_i(byteSelect),
    .de_o(video_de),
    .rgb_o(video_pixel),
    .hs_o(video_hsync),
    .vs_o(video_vsync)
);

serial_ctrl serial_ctrl_ist(
    .clk(clk25),
    .rst(rst),
    .enable_i(comEnable),
    .readEnable_i(comReadEnable),
    .mode_i(addr[2]),
    .dataSave_i(comDataSave),
    .dataLoad_o(comDataLoad),
    .int_o(comInt),
    .rxdReady_i(rxdReady),
    .rxdData_i(rxdData),
    .txdBusy_i(txdBusy),
    .txdStart_o(txdStart),
    .txdData_o(txdData)
);

wire usbTriStateWrite;
usb_ctrl usb_ctrl_ist(
    .clk(clk25),
    .rst(rst),
    .devEnable_i(usbEnable),
    .addr_i(addr),
    .readEnable_i(usbReadEnable),
    .writeEnable_i(usbWriteEnable),
    .busy_o(usbBusy),
    .int_o(usbInt),
    .triStateWrite_o(usbTriStateWrite),
    .usbA0_o(sl811_a0),
    .usbWE_o(sl811_we_n),
    .usbRD_o(sl811_rd_n),
    .usbCS_o(sl811_cs_n),
    .usbRst_o(sl811_rst_n),
    .usbDACK_o(sl811_dack),
    .usbInt_i(sl811_int)
);
assign sl811_data = usbTriStateWrite ? usbWriteData[7:0] : 8'hzz;
assign usbReadData = {24'b0, sl811_data};

boot_ctrl boot_ctrl_ist(
    .addr_i(addr),
    .readData_o(bootDataLoad)
);

lattice_ram_ctrl lattice_ram_ctrl_ist(
    .clk(clk25),
    .rst(rst),
    .devEnable_i(ltcEnable),
    .readEnable_i(ltcReadEnable),
    .addr_i(addr),
    .readData_o(ltcDataLoad),
    .busy_o(ltcBusy)
);

wire ethTriStateWrite;
eth_ctrl eth_ctrl_ist(
    .clk(clk25),
    .rst(rst),
    .enable_i(ethEnable),
    .readEnable_i(ethReadEnable),
    .addr_i(addr),
    .writeBusy_o(ethWriteBusy),
    .int_o(ethInt),
    .triStateWrite_o(ethTriStateWrite),

    .ethInt_i(dm9k_int),
    .ethCmd_o(dm9k_cmd),
    .ethWE_o(dm9k_we_n),
    .ethRD_o(dm9k_rd_n),
    .ethCS_o(dm9k_cs_n),
    .ethRst_o(dm9k_rst_n)
);
assign dm9k_data = ethTriStateWrite ? ethDataSave[15:0] : 16'hzzzz;
assign ethDataLoad = {16'b0, dm9k_data};

always@(posedge clk25) begin
    if (rst == 1) begin
        ledHold <= 0;
        numberHold <= 0;
    end else begin
        if (ledEnable)
            ledHold <= ledData;
        if (numEnable)
            numberHold <= numData;
    end
end

/* sram_ctrl Test 1: Alternatively write and read
 * 1. Press and release rst
 * 2. LED should show 0xAAAA pattern
 */
/*
reg[15:0] count, correct, testDataSave;
reg reading;
assign addr = count;
assign ramEnable = 1;
assign ramReadEnable = reading;
assign byteSelect = 4'hf;
assign leds[15:0] = correct;
assign ramDataSave = {16'h0, testDataSave};
always@(posedge clk25) begin
    if (rst) begin
        count <= 0;
        correct <= 0;
        reading <= 0;
    end else begin
        if (count < 16'haaaa || reading == 0) begin
            if (reading == 0) begin
                testDataSave <= count;
            end else begin
                if (ramDataLoad[15:0] == count)
                    correct <= correct + 1;
                count <= count + 1;
            end
            reading <= ~reading;
        end
    end
end
*/

/* sram_ctrl Test 2: Load arbitary data
 * 1. Upload RAM initializing file
 * 2. Press and release reset
 * 3. Set the switches and watch the LEDs
 */
/*
assign ramEnable = 1;
assign ramReadEnable = 1;
assign byteSelect = 4'hf;
assign addr = dip_sw;
assign leds[15:0] = ramDataLoad[15:0];
*/

endmodule
