oscourse-tsinghua/OS2018spring-projects-g05/myCPU/dev/serial_ctrl.vhd

library ieee;
use ieee.std_logic_1164.all;
use work.global_const.all;
use work.bus_const.all;

entity serial_ctrl is
    port (
        clk, rst: in std_logic;

        cpu_i: in BusC2D; -- addr: 0xBFD003FC for status, 0xBFD003F8 for data
        cpu_o: out BusD2C;

        int_o: out std_logic; -- Interruption

        rxdReady_i: in std_logic;
        rxdData_i: in std_logic_vector(7 downto 0); -- rxdReady_i and rxdData_i only hold for 1 period
        txdBusy_i: in std_logic;
        txdStart_o: out std_logic;
        txdData_o: out std_logic_vector(7 downto 0)
    );
end serial_ctrl;

architecture bhv of serial_ctrl is
    signal recvAvail: std_logic;
    signal recvData: std_logic_vector(7 downto 0);
    signal txIRE, rxIRE: std_logic; -- Interrupt Enable
    constant TX_READY: integer := 0;
    constant RX_READY: integer := 1;
    constant TX_IRE: integer := 3;
    constant RX_IRE: integer := 4;
begin
    cpu_o.dataLoad <= (
            TX_READY => not txdBusy_i,
            RX_READY => rxdReady_i or recvAvail,
            TX_IRE => txIRE,
            RX_IRE => rxIRE,
            others => '0'
        ) when cpu_i.addr(2) = '1' else
            24ux"0" & rxdData_i when rxdReady_i = '1' else 24ux"0" & recvData;
    -- When recvAvail = NO or chip disabled, outputting whatever is OK

    cpu_o.busy <= PIPELINE_NONSTOP;

    int_o <= ((rxdReady_i or recvAvail) and rxIRE) or (not txdBusy_i and txIRE);

    process (clk) begin
        if (rising_edge(clk)) then
            txdStart_o <= '0';
            txdData_o <= (others => '0');
            if (rst = RST_ENABLE) then
                recvAvail <= NO;
                recvData <= (others => '0');
                txIRE <= NO;
                rxIRE <= YES;
            else
                if (rxdReady_i = '1') then
                    recvAvail <= YES;
                    recvData <= rxdData_i;
                end if;
                if (cpu_i.enable = ENABLE and cpu_i.write = NO and cpu_i.addr(2) = '0') then
                    recvAvail <= NO;
                    recvData <= (others => '0');
                end if;

                if (cpu_i.enable = ENABLE and cpu_i.write = YES) then
                    if (cpu_i.addr(2) = '1') then
                        txIRE <= cpu_i.dataSave(TX_IRE);
                        rxIRE <= cpu_i.dataSave(RX_IRE);
                    elsif (txdBusy_i = '0') then -- cpu_i.addr(2) = '0'
                        -- If busy, ignore it
                        txdStart_o <= '1';
                        txdData_o <= cpu_i.dataSave(7 downto 0);
                    end if;
                end if;
            end if;
        end if;
    end process;
end bhv;
