oscourse-tsinghua/OS2018spring-projects-g05/myCPU/datapath/ex.vhd

library ieee;
use ieee.std_logic_1164.all;
use ieee.std_logic_unsigned.all;
use ieee.numeric_std.all;
-- NOTE: std_logic_unsigned cannot be used at the same time with std_logic_signed
--       Use numeric_std if signed number is needed (different API)
use work.global_const.all;
use work.alu_const.all;
use work.mem_const.all;
use work.except_const.all;
use work.cp0_const.all;

entity ex is
    generic (
        extraCmd: boolean
    );
    port (
        alut_i: in AluType;
        memt_i: in MemType;
        operand1_i: in std_logic_vector(DataWidth);
        operand2_i: in std_logic_vector(DataWidth);
        operandX_i: in std_logic_vector(DataWidth);
        toWriteReg_i: in std_logic;
        writeRegAddr_i: in std_logic_vector(RegAddrWidth);
        linkAddress_i: in std_logic_vector(AddrWidth);
        isInDelaySlot_i: in std_logic;
        toStall_o: out std_logic;
        toWriteReg_o: out std_logic;
        writeRegAddr_o: out std_logic_vector(RegAddrWidth);
        writeRegData_o: out std_logic_vector(DataWidth);

        -- Hi Lo --
        hi_i, lo_i: in std_logic_vector(DataWidth);
        memToWriteHi_i, memToWriteLo_i: in std_logic;
        memWriteHiData_i, memWriteLoData_i: in std_logic_vector(DataWidth);
        wbToWriteHi_i, wbToWriteLo_i: in std_logic;
        wbWriteHiData_i, wbWriteLoData_i: in std_logic_vector(DataWidth);
        toWriteHi_o, toWriteLo_o: out std_logic;
        writeHiData_o, writeLoData_o: out std_logic_vector(DataWidth);

        -- Memory --
        memt_o: out MemType;
        memAddr_o: out std_logic_vector(AddrWidth);
        memData_o: out std_logic_vector(DataWidth);

        -- multi-period --
        tempProduct_i: in std_logic_vector(DoubleDataWidth);
        cnt_i: in std_logic_vector(CntWidth);
        tempProduct_o: out std_logic_vector(DoubleDataWidth);
        cnt_o: out std_logic_vector(CntWidth);

        -- interact with div --
        divBusy_i: in std_logic;
        quotient_i, remainder_i: in std_logic_vector(DataWidth);
        divEnable_o: out std_logic;
        dividend_o, divider_o: out std_logic_vector(DataWidth);

        -- interact with CP0 --
        cp0RegData_i: in std_logic_vector(DataWidth);
        cp0RegDataValid_i: in std_logic;
        memCP0RegData_i: in std_logic_vector(DataWidth);
        memCP0RegWriteAddr_i: in std_logic_vector(CP0RegAddrWidth);
        memCP0RegWe_i: in std_logic;
        cp0RegReadAddr_o: out std_logic_vector(CP0RegAddrWidth);
        cp0RegReadSel_o: out std_logic_vector(SelWidth);
        cp0RegData_o: out std_logic_vector(DataWidth);
        cp0RegWriteAddr_o: out std_logic_vector(CP0RegAddrWidth);
        cp0RegWriteSel_o: out std_logic_vector(SelWidth);
        cp0RegWe_o: out std_logic;
        cp0Sp_o: out CP0Special;

        -- for exception --
        valid_i: in std_logic;
        valid_o: out std_logic;
        noInt_i: in std_logic;
        noInt_o: out std_logic;
        exceptCause_i: in std_logic_vector(ExceptionCauseWidth);
        tlbRefill_i: in std_logic;
        currentInstAddr_i: in std_logic_vector(AddrWidth);
        exceptCause_o: out std_logic_vector(ExceptionCauseWidth);
        tlbRefill_o: out std_logic;
        isInDelaySlot_o: out std_logic;
        currentInstAddr_o: out std_logic_vector(AddrWidth);
        flushForceWrite_i: in std_logic;
        flushForceWrite_o: out std_logic
    );
end ex;

architecture bhv of ex is

    function complement(x: std_logic_vector(DataWidth)) return std_logic_vector is
    begin
        return (not x) + 1;
    end complement;

    function complement64(x: std_logic_vector(DoubleDataWidth)) return std_logic_vector is
    begin
        return (not x) + 1;
    end complement64;

    function addOverflow(x, y: std_logic_vector(DataWidth)) return boolean is
        variable res: std_logic_vector(DataWidth);
    begin
        res := x + y;
        return ((x(31)  or y(31)) = '0' and res(31) = '1') or
               ((x(31) and y(31)) = '1' and res(31) = '0');
    end addOverflow;

    function subOverflow(x, y: std_logic_vector(DataWidth)) return boolean is
        variable res: std_logic_vector(DataWidth);
    begin
        res := x - y;
        return (x(31) and not y(31) and not res(31)) = '1' or -- Negative - positive -> positive
               (not x(31) and y(31) and res(31)) = '1'; -- Positive - negative -> negative
    end subOverflow;

    signal realHiData, realLoData: std_logic_vector(DataWidth) := (others => '0');
    signal clo, clz: std_logic_vector(DataWidth);

    signal multip1, multip2: std_logic_vector(DataWidth);
    signal calcMult: std_logic := '0';
    signal product: std_logic_vector(DoubleDataWidth);
    signal trapAssert: std_logic;
    signal reg1Ltreg2: std_logic;
begin
    memt_o <= memt_i;
    flushForceWrite_o <= flushForceWrite_i;

    clo <= 32ux"00" when operand1_i(31) = '0' else 32ux"01" when operand1_i(30) = '0' else
           32ux"02" when operand1_i(29) = '0' else 32ux"03" when operand1_i(28) = '0' else
           32ux"04" when operand1_i(27) = '0' else 32ux"05" when operand1_i(26) = '0' else
           32ux"06" when operand1_i(25) = '0' else 32ux"07" when operand1_i(24) = '0' else
           32ux"08" when operand1_i(23) = '0' else 32ux"09" when operand1_i(22) = '0' else
           32ux"0a" when operand1_i(21) = '0' else 32ux"0b" when operand1_i(20) = '0' else
           32ux"0c" when operand1_i(19) = '0' else 32ux"0d" when operand1_i(18) = '0' else
           32ux"0e" when operand1_i(17) = '0' else 32ux"0f" when operand1_i(16) = '0' else
           32ux"10" when operand1_i(15) = '0' else 32ux"11" when operand1_i(14) = '0' else
           32ux"12" when operand1_i(13) = '0' else 32ux"13" when operand1_i(12) = '0' else
           32ux"14" when operand1_i(11) = '0' else 32ux"15" when operand1_i(10) = '0' else
           32ux"16" when operand1_i( 9) = '0' else 32ux"17" when operand1_i( 8) = '0' else
           32ux"18" when operand1_i( 7) = '0' else 32ux"19" when operand1_i( 6) = '0' else
           32ux"1a" when operand1_i( 5) = '0' else 32ux"1b" when operand1_i( 4) = '0' else
           32ux"1c" when operand1_i( 3) = '0' else 32ux"1d" when operand1_i( 2) = '0' else
           32ux"1e" when operand1_i( 1) = '0' else 32ux"1f" when operand1_i( 0) = '0' else
           32ux"20";
    clz <= 32ux"00" when operand1_i(31) = '1' else 32ux"01" when operand1_i(30) = '1' else
           32ux"02" when operand1_i(29) = '1' else 32ux"03" when operand1_i(28) = '1' else
           32ux"04" when operand1_i(27) = '1' else 32ux"05" when operand1_i(26) = '1' else
           32ux"06" when operand1_i(25) = '1' else 32ux"07" when operand1_i(24) = '1' else
           32ux"08" when operand1_i(23) = '1' else 32ux"09" when operand1_i(22) = '1' else
           32ux"0a" when operand1_i(21) = '1' else 32ux"0b" when operand1_i(20) = '1' else
           32ux"0c" when operand1_i(19) = '1' else 32ux"0d" when operand1_i(18) = '1' else
           32ux"0e" when operand1_i(17) = '1' else 32ux"0f" when operand1_i(16) = '1' else
           32ux"10" when operand1_i(15) = '1' else 32ux"11" when operand1_i(14) = '1' else
           32ux"12" when operand1_i(13) = '1' else 32ux"13" when operand1_i(12) = '1' else
           32ux"14" when operand1_i(11) = '1' else 32ux"15" when operand1_i(10) = '1' else
           32ux"16" when operand1_i( 9) = '1' else 32ux"17" when operand1_i( 8) = '1' else
           32ux"18" when operand1_i( 7) = '1' else 32ux"19" when operand1_i( 6) = '1' else
           32ux"1a" when operand1_i( 5) = '1' else 32ux"1b" when operand1_i( 4) = '1' else
           32ux"1c" when operand1_i( 3) = '1' else 32ux"1d" when operand1_i( 2) = '1' else
           32ux"1e" when operand1_i( 1) = '1' else 32ux"1f" when operand1_i( 0) = '1' else
           32ux"20";

    isInDelaySlot_o <= isInDelaySlot_i;
    currentInstAddr_o <= currentInstAddr_i;
    valid_o <= valid_i;
    noInt_o <= noInt_i;

    -- multiplication --
    process(multip1, multip2, alut_i, calcMult)
        variable m1, m2: std_logic_vector(DataWidth);
        variable ans: std_logic_vector(DoubleDataWidth);
        variable sgnMul: boolean;
        variable neg: boolean;
    begin
        if (alut_i = ALU_MULTU or (extraCmd and (alut_i = ALU_MADDU or alut_i = ALU_MSUBU))) then
            sgnMul := false;
        else
            sgnMul := true;
        end if;

        neg := false;
        if (calcMult = '1') then
            if (sgnMul and multip1(31) = '1') then
                m1 := complement(multip1);
                neg := not neg;
            else
                m1 := multip1;
            end if;
            if (sgnMul and multip2(31) = '1') then
                m2 := complement(multip2);
                neg := not neg;
            else
                m2 := multip2;
            end if;
        end if;

        ans := m1 * m2;
        if (neg) then
            product <= complement64(ans);
        else
            product <= ans;
        end if;
    end process;

    -- hi lo --
    process(all) begin
        realHiData <= hi_i;
        realLoData <= lo_i;
        if (wbToWriteHi_i = YES) then
            realHiData <= wbWriteHiData_i;
        end if;
        if (memToWriteHi_i = YES) then
            realHiData <= memWriteHiData_i;
        end if;
        if (wbToWriteLo_i = YES) then
            realLoData <= wbWriteLoData_i;
        end if;
        if (memToWriteLo_i = YES) then
            realLoData <= memWriteLoData_i;
        end if;
    end process;

    process(all)
        variable res: std_logic_vector(DataWidth);
        variable res64: std_logic_vector(DoubleDataWidth);
        variable ovSum: std_logic;
    begin
        toWriteHi_o <= NO;
        toWriteLo_o <= NO;
        toWriteReg_o <= toWriteReg_i;
        memAddr_o <= (others => '0');
        memData_o <= (others => '0');
        writeRegAddr_o <= writeRegAddr_i;
        writeRegData_o <= (others => '0');
        toStall_o <= PIPELINE_NONSTOP;
        calcMult <= '0';
        tempProduct_o <= (others => '0');
        cnt_o <= (others => '0');
        cp0RegWe_o <= NO;
        cp0RegWriteAddr_o <= (others => '0');
        cp0RegWriteSel_o <= (others => '0');
        cp0RegData_o <= (others => '0');
        cp0Sp_o <= INVALID;
        writeHiData_o <= (others => '0');
        writeLoData_o <= (others => '0');
        cp0RegReadAddr_o <= (others => '0');
        cp0RegReadSel_o <= (others => '0');
        divEnable_o <= DISABLE;
        dividend_o <= (others => '0');
        divider_o <= (others => '0');

        exceptCause_o <= exceptCause_i;
        tlbRefill_o <= tlbRefill_i;

        res64 := (others => 'X');
        ovSum := NO; -- Otherwise it will introduce a level latch to keep the prior value

        if (extraCmd) then
            case alut_i is
                when ALU_MOVN =>
                    if (operand2_i /= ZEROS_32) then
                        writeRegData_o <= operand1_i;
                    else
                        toWriteReg_o <= NO;
                        writeRegData_o <= (others => '0');
                    end if;

                when ALU_MOVZ =>
                    if (operand2_i = ZEROS_32) then
                        writeRegData_o <= operand1_i;
                    else
                        toWriteReg_o <= NO;
                        writeRegData_o <= (others => '0');
                    end if;

                when ALU_MADD | ALU_MADDU | ALU_MSUB | ALU_MSUBU =>
                    if (cnt_i = "00") then
                        calcMult <= '1';
                        multip1 <= operand1_i;
                        multip2 <= operand2_i;
                        tempProduct_o <= product;
                        cnt_o <= "01";
                        toStall_o <= PIPELINE_STOP;
                    elsif (cnt_i = "01") then
                        calcMult <= '0';
                        tempProduct_o <= (others => '0');
                        cnt_o <= "00";
                        toStall_o <= PIPELINE_NONSTOP;
                        toWriteHi_o <= YES;
                        toWriteLo_o <= YES;
                        if (alut_i = ALU_MADD or alut_i = ALU_MADDU) then
                            res64 := (realHiData & realLoData) + tempProduct_i;
                        elsif (alut_i = ALU_MSUB or alut_i = ALU_MSUBU) then
                            res64 := (realHiData & realLoData) - tempProduct_i;
                        end if;
                        writeHiData_o <= res64(HiDataWidth);
                        writeLoData_o <= res64(LoDataWidth);
                    end if;

                when ALU_TLBWI =>
                    cp0Sp_o <= CP0SP_TLBWI;

                when ALU_TLBWR =>
                    cp0Sp_o <= CP0SP_TLBWR;

                when ALU_TLBP =>
                    cp0Sp_o <= CP0SP_TLBP;

                when ALU_TLBR =>
                    cp0Sp_o <= CP0SP_TLBR;

                when ALU_TLBINVF =>
                    cp0Sp_o <= CP0SP_TLBINVF;

                when others =>
                    null;
            end case;
        end if;
        case alut_i is
            when ALU_OR => writeRegData_o <= operand1_i or operand2_i;
            when ALU_AND => writeRegData_o <= operand1_i and operand2_i;
            when ALU_XOR => writeRegData_o <= operand1_i xor operand2_i;
            when ALU_NOR => writeRegData_o <= operand1_i nor operand2_i;
            when ALU_SLL => writeRegData_o <= operand2_i sll to_integer(unsigned(operand1_i(4 downto 0)));
            when ALU_SRL => writeRegData_o <= operand2_i srl to_integer(unsigned(operand1_i(4 downto 0)));
            when ALU_SRA => writeRegData_o <= to_stdlogicvector(
                to_bitvector(operand2_i) sra to_integer(unsigned(operand1_i(4 downto 0)))
            );
            when ALU_LUI => writeRegData_o <= operand1_i(15 downto 0) & 16b"0";
            when ALU_JBAL => writeRegData_o <= linkAddress_i;

            when ALU_MFHI =>
                writeRegData_o <= realHiData;

            when ALU_MFLO =>
                writeRegData_o <= realLoData;

            when ALU_MFH =>
                writeRegAddr_o <= (others => '0');

            when ALU_MTHI =>
                toWriteHi_o <= YES;
                writeHiData_o <= operand1_i;

            when ALU_MTLO =>
                toWriteLo_o <= YES;
                writeLoData_o <= operand1_i;

            when ALU_LOAD =>
                memAddr_o <= to_stdlogicvector(operand1_i + to_integer(signed(operandX_i(15 downto 0))));

            when ALU_STORE =>
                memAddr_o <= to_stdlogicvector(operand1_i + to_integer(signed(operandX_i(15 downto 0))));
                memData_o <= operand2_i;

            when ALU_ADD =>
                if (addOverflow(operand1_i, operand2_i)) then
                    ovSum := YES;
                else
                    writeRegData_o <= operand1_i + operand2_i;
                end if;

            when ALU_ADDU =>
                writeRegData_o <= operand1_i + operand2_i;

            when ALU_SUB =>
                if (subOverflow(operand1_i, operand2_i)) then
                    ovSum := YES;
                else
                    writeRegData_o <= operand1_i - operand2_i;
                end if;

            when ALU_SUBU =>
                writeRegData_o <= operand1_i - operand2_i;

            when ALU_SLT =>
                res := operand1_i - operand2_i;
                if (not subOverflow(operand1_i, operand2_i)) then
                    writeRegData_o <= ZEROS_31 & res(31);
                else
                    writeRegData_o <= ZEROS_31 & (not res(31));
                end if;

            when ALU_SLTU =>
                if (operand1_i < operand2_i) then
                    writeRegData_o <= ZEROS_31 & '1';
                else
                    writeRegData_o <= ZEROS_31 & '0';
                end if;

            when ALU_CLO => writeRegData_o <= clo;

            when ALU_CLZ => writeRegData_o <= clz;

            when ALU_MUL =>
                calcMult <= '1';
                multip1 <= operand1_i;
                multip2 <= operand2_i;
                writeRegData_o <= product(LoDataWidth);

            when ALU_MULT =>
                calcMult <= '1';
                multip1 <= operand1_i;
                multip2 <= operand2_i;
                toWriteHi_o <= YES;
                writeHiData_o <= product(HiDataWidth);
                toWriteLo_o <= YES;
                writeLoData_o <= product(LoDataWidth);

            when ALU_MULTU =>
                calcMult <= '1';
                multip1 <= operand1_i;
                multip2 <= operand2_i;
                toWriteHi_o <= YES;
                writeHiData_o <= product(HiDataWidth);
                toWriteLo_o <= YES;
                writeLoData_o <= product(LoDataWidth);

            when ALU_DIV =>
                toWriteHi_o <= YES;
                toWriteLo_o <= YES;
                divEnable_o <= ENABLE;
                toStall_o <= divBusy_i;

                if (operand1_i(31) = '0') then
                    if (operand2_i(31) = '0') then
                        writeHiData_o <= remainder_i;
                        writeLoData_o <= quotient_i;
                        dividend_o <= operand1_i;
                        divider_o <= operand2_i;
                    else
                        writeHiData_o <= remainder_i;
                        writeLoData_o <= complement(quotient_i);
                        dividend_o <= operand1_i;
                        divider_o <= complement(operand2_i);
                    end if;
                else
                    if (operand2_i(31) = '0') then
                        writeHiData_o <= complement(remainder_i);
                        writeLoData_o <= complement(quotient_i);
                        dividend_o <= complement(operand1_i);
                        divider_o <= operand2_i;
                    else
                        writeHiData_o <= complement(remainder_i);
                        writeLoData_o <= quotient_i;
                        dividend_o <= complement(operand1_i);
                        divider_o <= complement(operand2_i);
                    end if;
                end if;

            when ALU_DIVU =>
                toWriteHi_o <= YES;
                writeHiData_o <= remainder_i;
                toWriteLo_o <= YES;
                writeLoData_o <= quotient_i;
                divEnable_o <= ENABLE;
                toStall_o <= divBusy_i;
                dividend_o <= operand1_i;
                divider_o <= operand2_i;

            when ALU_MFC0 =>
                cp0RegReadAddr_o <= operand1_i(4 downto 0);
                cp0RegReadSel_o <= operandX_i(SelWidth);
                writeRegData_o <= cp0RegData_i;
                if (cp0RegDataValid_i = NO) then
                    toStall_o <= PIPELINE_STOP;
                end if;

                -- Push forward for cp0 --
                if (memCP0RegWe_i = YES and memCP0RegWriteAddr_i = operand1_i(4 downto 0)) then
                    toStall_o <= PIPELINE_STOP;
                end if;

            when ALU_MTC0 =>
                cp0RegWriteAddr_o <= operand1_i(4 downto 0);
                cp0RegWriteSel_o <= operandX_i(SelWidth);
                cp0RegWe_o <= YES;
                cp0RegData_o <= operand2_i;

            when others =>
                null;
        end case;
        if ((alut_i = ALU_ADD) or (alut_i = ALU_SUB)) then
            if (ovSum = YES) then
                toWriteReg_o <= NO;
                exceptCause_o <= OVERFLOW_CAUSE;
            else
                toWriteReg_o <= YES;
            end if;
        end if;

        if (
            ((memt_i = MEM_LW or memt_i = MEM_SW) and memAddr_o(1 downto 0) /= "00") or
            ((memt_i = MEM_LH or memt_i = MEM_LHU or memt_i = MEM_SH) and memAddr_o(0) /= '0')
        ) then
            if (alut_i = ALU_LOAD) then
                exceptCause_o <= ADDR_ERR_LOAD_OR_IF_CAUSE;
            else
                exceptCause_o <= ADDR_ERR_STORE_CAUSE;
            end if;
        end if;
    end process;

end bhv;
