oscourse-tsinghua/OS2018spring-projects-g05/myCPU/const/inst_const.vhd

library ieee;
use ieee.std_logic_1164.all;

package inst_const is

    --
    -- Format of instructions, classified into R type, I type and J type
    --
    subtype InstOpIdx               is integer range 31 downto 26;
    subtype InstRsIdx               is integer range 25 downto 21;
    subtype InstRtIdx               is integer range 20 downto 16;
    subtype InstRdIdx               is integer range 15 downto 11;
    subtype InstSaIdx               is integer range 10 downto  6;
    subtype InstFuncIdx             is integer range  5 downto  0;
    subtype InstImmIdx              is integer range 15 downto  0;
    subtype InstUnsignedImmIdx      is integer range 14 downto  0;
    subtype InstImmSignIdx          is integer range 15 downto 15;
    subtype InstAddrIdx             is integer range 25 downto  0;
    subtype InstJmpUnchangeIdx      is integer range 31 downto 28;
    subtype InstImmAddrIdx          is integer range 25 downto  0;
    subtype InstSaFuncIdx           is integer range 10 downto  3;
    subtype InstSelIdx              is integer range  2 downto  0;

    subtype InstOpWidth             is integer range  5 downto  0;
    subtype InstRsWidth             is integer range  4 downto  0;
    subtype InstRtWidth             is integer range  4 downto  0;
    subtype InstRdWidth             is integer range  4 downto  0;
    subtype InstSaWidth             is integer range  4 downto  0;
    subtype InstFuncWidth           is integer range  5 downto  0;
    subtype InstImmWidth            is integer range 15 downto  0;
    subtype InstUnsignedImmWidth    is integer range 14 downto  0;
    subtype InstImmSignWidth        is integer range 15 downto 15;
    subtype InstAddrWidth           is integer range 25 downto  0;
    subtype InstJmpUnchangeWidth    is integer range  3 downto  0;
    subtype InstImmAddrWidth        is integer range 25 downto  0;
    subtype InstOffsetImmWidth      is integer range 17 downto  0;
    subtype InstSaFuncWidth         is integer range  7 downto  0;

    --
    -- Logic OP/FUNC codes
    --
    constant FUNC_AND: std_logic_vector(InstFuncWidth) := "100100";
    constant FUNC_OR: std_logic_vector(InstFuncWidth) := "100101";
    constant FUNC_XOR: std_logic_vector(InstFuncWidth) := "100110";
    constant FUNC_NOR: std_logic_vector(InstFuncWidth) := "100111";

    constant OP_ANDI: std_logic_vector(InstOpWidth) := "001100";
    constant OP_ORI: std_logic_vector(InstOpWidth) := "001101";
    constant OP_XORI: std_logic_vector(InstOpWidth) := "001110";
    constant OP_LUI: std_logic_vector(InstOpWidth) := "001111";
    constant OP_PREF: std_logic_vector(InstOpWidth) := "110011";

    --
    -- Algebraic FUNC codes
    --
    constant FUNC_SLL: std_logic_vector(InstFuncWidth) := "000000";
    constant FUNC_SLLV: std_logic_vector(InstFuncWidth) := "000100";
    constant FUNC_SRL: std_logic_vector(InstFuncWidth) := "000010";
    constant FUNC_SRLV: std_logic_vector(InstFuncWidth) := "000110";
    constant FUNC_SRA: std_logic_vector(InstFuncWidth) := "000011";
    constant FUNC_SRAV: std_logic_vector(InstFuncWidth) := "000111";

    --
    -- Move FUNC codes
    --
    constant FUNC_MOVN: std_logic_vector(InstFuncWidth) := "001011";
    constant FUNC_MOVZ: std_logic_vector(InstFuncWidth) := "001010";
    constant FUNC_MFHI: std_logic_vector(InstFuncWidth) := "010000";
    constant FUNC_MFLO: std_logic_vector(InstFuncWidth) := "010010";
    constant FUNC_MTHI: std_logic_vector(InstFuncWidth) := "010001";
    constant FUNC_MTLO: std_logic_vector(InstFuncWidth) := "010011";

    --
    -- TRAP
    --
    constant FUNC_TNE: std_logic_vector(InstFuncWidth) := "110110";

    --
    -- Memory OP codes
    --
    constant OP_LB: std_logic_vector(InstOpWidth) := "100000";
    constant OP_LBU: std_logic_vector(InstOpWidth) := "100100";
    constant OP_LH: std_logic_vector(InstOpWidth) := "100001";
    constant OP_LHU: std_logic_vector(InstOpWidth) := "100101";
    constant OP_LW: std_logic_vector(InstOpWidth) := "100011";
    constant OP_LWL: std_logic_vector(InstOpWidth) := "100010";
    constant OP_LWR: std_logic_vector(InstOpWidth) := "100110";
    constant OP_SB: std_logic_vector(InstOpWidth) := "101000";
    constant OP_SH: std_logic_vector(InstOpWidth) := "101001";
    constant OP_SW: std_logic_vector(InstOpWidth) := "101011";
    constant OP_SWL: std_logic_vector(InstOpWidth) := "101010";
    constant OP_SWR: std_logic_vector(InstOpWidth) := "101110";
    constant OP_LL: std_logic_vector(InstOpWidth) := "110000";
    constant OP_SC: std_logic_vector(InstOpWidth) := "111000";

    --
    -- Arith OP/FUNC codes
    --
    constant FUNC_ADD: std_logic_vector(InstFuncWidth) := "100000";
    constant FUNC_ADDU: std_logic_vector(InstFuncWidth) := "100001";
    constant FUNC_SUB: std_logic_vector(InstFuncWidth) := "100010";
    constant FUNC_SUBU: std_logic_vector(InstFuncWidth) := "100011";
    constant FUNC_SLT: std_logic_vector(InstFuncWidth) := "101010";
    constant FUNC_SLTU: std_logic_vector(InstFuncWidth) := "101011";
    constant FUNC_MULT: std_logic_vector(InstFuncWidth) := "011000";
    constant FUNC_MULTU: std_logic_vector(InstFuncWidth) := "011001";

    constant OP_ADDI: std_logic_vector(InstOpWidth) := "001000";
    constant OP_ADDIU: std_logic_vector(InstOpWidth) := "001001";
    constant OP_SLTI: std_logic_vector(InstOpWidth) := "001010";
    constant OP_SLTIU: std_logic_vector(InstOpWidth) := "001011";

    constant FUNC_CLO: std_logic_vector(InstFuncWidth) := "100001";
    constant FUNC_CLZ: std_logic_vector(InstFuncWidth) := "100000";
    constant FUNC_MUL: std_logic_vector(InstFuncWidth) := "000010";

    constant FUNC_MADD: std_logic_vector(InstFuncWidth) := "000000";
    constant FUNC_MADDU: std_logic_vector(InstFuncWidth) := "000001";
    constant FUNC_MSUB: std_logic_vector(InstFuncWidth) := "000100";
    constant FUNC_MSUBU: std_logic_vector(InstFuncWidth) := "000101";

    constant FUNC_DIV: std_logic_vector(InstFuncWidth) := "011010";
    constant FUNC_DIVU: std_logic_vector(InstFuncWidth) := "011011";

    constant FUNC_WAIT: std_logic_vector(InstFuncWidth) := "100000";

    --
    -- Jump Opcodes
    --
    constant JMP_JALR: std_logic_vector(InstFuncWidth) := "001001";
    constant JMP_JR: std_logic_vector(InstFuncWidth):= "001000";

    constant JMP_BLTZ: std_logic_vector(InstRtWidth) := "00000";
    constant JMP_BLTZL: std_logic_vector(InstRtWidth) := "00010";
    constant JMP_BGEZ: std_logic_vector(InstRtWidth) := "00001";
    constant JMP_BGEZL: std_logic_vector(InstRtWidth) := "00011";
    constant JMP_BLTZAL: std_logic_vector(InstRtWidth) := "10000";
    constant JMP_BGEZAL: std_logic_vector(InstRtWidth) := "10001";

    constant JMP_BEQ: std_logic_vector(InstOpWidth) := "000100";
    constant JMP_BEQL: std_logic_vector(InstOpWidth) := "010100";
    constant JMP_BGTZ: std_logic_vector(InstOpWidth) := "000111";
    constant JMP_BGTZL: std_logic_vector(InstOpWidth) := "010111";
    constant JMP_BLEZ: std_logic_vector(InstOpWidth) := "000110";
    constant JMP_BLEZL: std_logic_vector(InstOpWidth) := "010110";
    constant JMP_J: std_logic_vector(InstOpWidth) := "000010";
    constant JMP_JAL: std_logic_vector(InstOpWidth) := "000011";
    constant JMP_BNE: std_logic_vector(InstOpWidth) := "000101";
    constant JMP_BNEL: std_logic_vector(InstOpWidth) := "010101";

    --
    -- CP0
    --
    constant OP_COP0: std_logic_vector(InstOpWidth) := "010000";
    constant RS_MF: std_logic_vector(InstRsWidth) := "00000";
    constant RS_MT: std_logic_vector(InstRsWidth) := "00100";
    constant RS_MFH: std_logic_vector(InstRsWidth) := "00010";
    constant RS_TLBINVF: std_logic_vector(InstRsWidth) := "10000";
    constant FUNC_TLBWI: std_logic_vector(InstFuncWidth) := "000010";
    constant FUNC_TLBWR: std_logic_vector(InstFuncWidth) := "000110";
    constant FUNC_TLBINVF: std_logic_vector(InstFuncWidth) := "000100";
    constant FUNC_TLBP: std_logic_vector(InstFuncWidth) := "001000";
    constant FUNC_TLBR: std_logic_vector(InstFuncWidth) := "000001";

    --
    -- Exceptions
    --
    constant RS_WAIT_OR_TLBINVF: std_logic_vector(InstRsWidth) := "10000";
    constant FUNC_SYSCALL: std_logic_vector(InstFuncWidth) := "001100";
    constant FUNC_ERET: std_logic_vector(InstFuncWidth) := "011000";
    constant FUNC_DERET: std_logic_vector(InstFuncWidth) := "011111";
    constant FUNC_BREAK: std_logic_vector(InstFuncWidth) := "001101";
    constant FUNC_SDBBP: std_logic_vector(InstFuncWidth) := "111111";

    --
    -- Special OP groups
    --
    constant OP_SPECIAL: std_logic_vector(InstOpWidth) := "000000";
    constant OP_SPECIAL2: std_logic_vector(InstOpWidth) := "011100";
    constant OP_JMPSPECIAL: std_logic_vector(InstOpWidth) := "000001";

    --
    -- Cache(unimplemented)
    --
    constant FUNC_SYNC: std_logic_vector(InstFuncWidth) := "001111";
    constant OP_CACHE: std_logic_vector(InstOpWidth) := "101111";

end inst_const;
