oscourse-tsinghua/OS2018spring-projects-g05/myCPU/const/mmu_const.vhd

library ieee;
use ieee.std_logic_1164.all;
use work.global_const.all;

package mmu_const is
    constant TLB_ENTRY_NUM: integer := 16;
    subtype TLBIndexWidth is integer range 3 downto 0;

    type TLBEntry is record
        hi, lo0, lo1: std_logic_vector(DataWidth);
    end record;
end mmu_const;
