oscourse-tsinghua/OS2018spring-projects-g05/myCPU/dev/boot_ctrl.vhd

library ieee;
use ieee.std_logic_1164.all;
use work.global_const.all;
use work.bus_const.all;

entity boot_ctrl is
    port (
        cpu_i: in BusC2D;
        cpu_o: out BusD2C
    );
end boot_ctrl;

architecture bhv of boot_ctrl is
    signal addr: std_logic_vector(6 downto 0);
begin
    addr <= cpu_i.addr(8 downto 2);

    cpu_o.busy <= PIPELINE_NONSTOP;
    with addr select cpu_o.dataLoad <=
       "00100100000010010000000011111111" when "0010000",
       "10001101111101000000000000000000" when "0101000",
       "00010010100000000000000000001100" when "0101111",
       "00100110110101100000000000000100" when "0110111",
       "00100100000011110000000000011100" when "0011100",
       "00000010000011110111100000100001" when "0100111",
       "00111100000100001011111000000000" when "0010010",
       "00000010000011110111100000100001" when "0011101",
       "00010000000000001111111111111111" when "1000010",
       "00111100000010000100011001001100" when "0010110",
       "00110010010100101111111111111111" when "0100010",
       "10001101111100100000000000000000" when "0100001",
       "00000000000000000000000000000000" when "1000111",
       "01000000000010000111100000000001" when "0000000",
       "00011110101000001111111111111000" when "0111010",
       "00110101000010000001000000100000" when "0000101",
       "00000000000000000000000000000000" when "0011001",
       "00100110110011110000000000000000" when "0110011",
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
       "00100110001100010000000000100000" when "0111100",
       "10101110100010000000000000000000" when "0110110",
       "00100110001011110000000000010000" when "0101001",
       "00000010000011110111100000100001" when "0110100",
       "00000000000000000000000000000000" when others;
end bhv;
