oscourse-tsinghua/OS2018spring-projects-g05/sim/integration_test/fake_ram.vhd

library ieee;
use ieee.std_logic_1164.all;
use work.global_const.all;
use work.integration_test_const.all;

entity fake_ram is
    port (
        rst: in std_logic;
        writeEnable_i, readEnable1_i, readEnable2_i: in std_logic;
        writeAddr_i: in std_logic_vector(AddrWidth);
        writeData_i: in std_logic_vector(DataWidth);
        byteSelect_i: in std_logic_vector(3 downto 0);
        readAddr1_i: in std_logic_vector(AddrWidth);
        readAddr2_i: in std_logic_vector(AddrWidth);
        readData1_o: out std_logic_vector(DataWidth);
        readData2_o: out std_logic_vector(DataWidth)
    );
end fake_ram;

architecture bhv of fake_ram is

    component ram
        port (
            clka, ena: in std_logic;
            wea: in std_logic_vector(3 downto 0);
            dina: in std_logic_vector(31 downto 0);
            addra: in std_logic_vector(RamAddrWidth);
            douta: out std_logic_vector(31 downto 0)
        );
    end component;

    type state is (FINISHED_WRITE, FINISHED_READ1, FINISHED_READ2);
    signal clk: std_logic;
    signal sample_clk: std_logic;     -- eliminating jitter
    signal current_state, next_state: state := FINISHED_READ2;
    signal we: std_logic_vector(3 downto 0);
    signal addr: std_logic_vector(AddrWidth);
    signal din, dout: std_logic_vector(DataWidth);
    signal rdata1, rdata2: std_logic_vector(DataWidth);

begin

    ram_ist: ram
    port map (
        clka => clk, ena => '1',
        wea => we, dina => din,
        addra => addr(RamAddrSliceWidth), douta => dout
    );

    process
    begin
        clk <= '0';
        wait for 0.3 ns;
        clk <= '1';
        wait for 0.3 ns;
    end process;

    process
    begin
        sample_clk <= '0';
        wait for 1.3 ns;
        sample_clk <= '1';
        wait for 1.3 ns;
    end process;

    process(clk)
    begin
        if (rst = RST_ENABLE) then
            current_state <= FINISHED_READ2;
        else
            if (rising_edge(clk)) then
                current_state <= next_state;
            end if;
        end if;
    end process;

    process(all)
    begin
        if (rst = RST_ENABLE) then
            we <= "0000";
            addr <= (others => '0');
            din <= (others => '0');
        else
            case current_state is
                when FINISHED_WRITE =>    -- READY_READ1
                    we <= "0000";
                    addr <= readAddr1_i;
                    next_state <= FINISHED_READ1;
                when FINISHED_READ1 =>    -- READY_READ2
                    we <= "0000";
                    if (readEnable1_i = ENABLE) then
                        rdata1 <= dout;
                    else
                        rdata1 <= (others => '0');
                    end if;
                    addr <= readAddr2_i;
                    next_state <= FINISHED_READ2;
                when FINISHED_READ2 =>    -- READY_WRITE
                    if (writeEnable_i = ENABLE) then
                        we <= byteSelect_i;
                    else
                        we <= "0000";
                    end if;
                    if (readEnable2_i = ENABLE) then
                        rdata2 <= dout;
                    else
                        rdata2 <= (others => '0');
                    end if;
                    din <= writeData_i;
                    addr <= writeAddr_i;
                    next_state <= FINISHED_WRITE;
                when others =>
                    next_state <= FINISHED_READ2;
            end case;
        end if;
    end process;

    -- eliminate jitter of rdata by sampling --
    process(sample_clk)
    begin
        if (rising_edge(sample_clk)) then
            readData1_o <= rdata1;
            readData2_o <= rdata2;
        end if;
    end process;

end bhv;
