oscourse-tsinghua/OS2018spring-projects-g05/(commit log)

2017-10-14 Empty but runnable testing framework
2017-10-15 UPDATE TEST FRAMEWORK: initialize instruction RAM
2017-10-15 Corrected some grammar mistakes in the coding style example
    [coding_style_example.vhd]
2017-10-15 TEST FRAMEWORK: parse DEFINE and ASSERT op
2017-10-15 TEST FRAMEWORK: Added readme
2017-10-16 regfile implements register group error-prone, need test
    [regfile.vhd]
2017-10-16 fix codes for hard_test add IMPORT for test case file to enable it to use packages so test signal aliases in test case files can use RegArrayType, which is convenient for showing value of each regist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
    [global_const.vhd, regfile.vhd, tb.vhd]
2017-10-17 amend hard_test fix conflict between consts in "hard_tests_gen" and those in "src/package" fix missing of ';' in code generated by build.py
    [fake_ram.vhd, tb.vhd, test_const.vhd]
2017-10-18 TEST FRAMEWORK: Now support specify time to assert
    Currently the CPU takes one period doing nothing after `rst` set to 0,
    so the 1st period to assert is Period 6.
    Other changes:
    -- Modified test ori/ori1. Now with 3 assertions. But the 3rd should
    pass after implementing push-forward.
    -- Change `intWidth` to `IntWidth` to meet the code style restriction
2017-10-20 add test samples for com-logic
2017-10-20 Revert "Merge branch 'combinational_logic' into 'master'"
    This reverts merge request !4
    [alu_const.vhd, coding_style_example.vhd, conv_endian.vhd, cpu.vhd, ex.vhd, ex_mem.vhd, fake_ram.vhd]
2017-10-20 Update test framework
    - Now use can type `make` to generate tests
    - Re-generate out-dated tests
    - Remove some redundent lines from build.py
2017-10-20 Revert "add combinational logics with tests"
    This reverts commit 44fd56457bfbd8da67e95b713a2033c5090fde87
    [alu_const.vhd, ex.vhd, id.vhd, inst_const.vhd, regfile.vhd]
2017-10-22 pipeline stall: finished not tested
    [cpu.vhd, ctrl.vhd, ex.vhd, ex_mem.vhd, global_const.vhd, id.vhd, id_ex.vhd, if_id.vhd]
2017-10-23 Corrected more syntax error. Really compiled this time
    [ex.vhd, ex_mem.vhd, mem.vhd]
2017-10-24 stall when loading conflit happens
    [cpu.vhd, id.vhd]
2017-10-28 add constant and reset for cp0
    [cp0_const.vhd, cp0_reg.vhd, global_const.vhd]
2017-10-28 Add necessary pin support for CP0 coprocessor
2017-10-28 Circuit structure debug and add support to delay slot
2017-11-02 Add some circuit structures
2017-11-02 Add all other circuit structure"
2017-11-03 asserts_gen finished jump and branch correctness verified by existing testcase files involving jump and branch NOTE: several consecutive jump or branch should be added as a special case into testcases
2017-11-06 fake_ram.vhd: preliminarily tested There exists 2~5 ns delay between update of input addr and update of output data or memory. Although efforts taken to eliminate jitter, it cannot be assuredly precl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
    [fake_ram.vhd]
2017-11-06 integration_test: can run finished, able to run (namely, without compile error), but not verified correctness NOTE: add 'generic' to cpu, designating inst_entrance_addr
    [cpu.vhd, fake_ram.vhd, integration_test.vhd, integration_test_const.vhd, pc_reg.vhd]
2017-11-06 memctrl module (close #22) and fixed a bug about timeInt_o (close #23)
    [conv_endian.vhd, cpu.vhd, ctrl.vhd, ex_mem.vhd, fake_ram.vhd, if_id.vhd, tb.vhd]
2017-11-07 put ram.xci into project; RamAddrWidth: 19->18 in order to fit into the kind of core designated: formally-set Width is too large for this kind of core
    [fake_ram.vhd, integration_test_const.vhd]
2017-11-07 report result of each test: passed/failed
    [integration_test.vhd, integration_test_const.vhd]
2017-11-08 fix fatal error in template_start.S formally-set value of LED_ADDR and NUM_ADDR is out of range of ram, which causes store operation into these two addrs to override value stored in another addrs, be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
2017-11-09 fix bug in convert.c and judging a line of zero should be inserted between text section and data section, otherwise, there would be a tiny misalignment between inst addr and inst data in data section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
    [convert.c, integration_test_const.vhd]
2017-11-09 Correct some OPs to FUNCs in ID
    [id.vhd, inst_const.vhd]
2017-11-09 hold branch info when IF stalled (close #29)
    [cpu.vhd, id_ex.vhd, pc_reg.vhd]
2017-11-09 Really fixed #29 now
    [cpu.vhd, id_ex.vhd, pc_reg.vhd]
2017-11-10 speed up JUDGE_CLK, fixing its bug and making it more robust
    [integration_test.vhd, integration_test_const.vhd]
2017-11-11 Really passed new test tlb1
    It was not passed in the last commit. See issue #32 for the reason
    [cp0_const.vhd, cpu.vhd, integration_test.vhd, mem.vhd, mmu.vhd, tb.vhd]
2017-11-18 fix timing sequence error in flash_ctrl
    [flash_ctrl.vhd]
2017-11-20 reserved_instructions exception solved re-test all the testcases, ones that originally passed still pass in addition, testcase on reserved-instruction exception pass on the other hand, add .gitignore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
    [id.vhd]
2017-11-21 add back devBusy which was missed out
    [cpu.vhd, integration_test.vhd, tb.vhd]
2017-11-22 add port: ramByteSelect (formally missed)
    [devctrl.vhd]
2017-11-22 add serial port control (not tested) (Vivado file might be broken)
    [devctrl.vhd, serial_ctrl.vhd, thinpad_top.v]
2017-11-23 CLOCK_DEDICATED_ROUTE FALSE for rst button. But why?
2017-11-23 fix other bugs and passed all test except case#66
    [id.vhd]
2017-11-23 hot fix: solved combinatial loop in ID
    [id.vhd]
2017-11-23 Parameter on top + Remove rst from MMCM
    - Add a parameter to suggest whether it's booting from flash. In Vivado,
    set it in Settings -> General -> Generics/Parameters.
    - Removed rst from MMCM. MMCM doesn't need to be reset after powered on,
    and we should watch lock signal after resetting it
    [thinpad_top.v]
2017-11-23 led and 7seg output
2017-11-24 Moved a tri-state signal out from sram_ctrl
    This is because Vivado may have problem in this scenario.
    I met problems when I attached an unrelated debug signal
    [thinpad_top.v]
2017-11-24 Fixed byte order conversion
    If we want to convert, we should convert all of the instrution fetching,
    data loading and data saving.
    And we don't need to convert it with our board.
    [conv_endian.vhd, cpu.vhd, datapath.vhd, integration_test.vhd, tb.vhd]
2017-11-24 add vga_ctrl and usb_ctrl into thinpad_top the former tested, the latter not not truly add, namely, not connected to devctrl yet on top of that, a weird error occurs in synthesizing, not know why
    [devctrl.vhd, thinpad_top.v]
2017-11-25 successfully generate bitstream substitute component declaration for "entity work.XXXX" curiously, the former is ok but the latter triggers synthesize error
    [thinpad_top.v]
2017-11-25 attach vga to devctrl; passed synthesis
2017-11-25 attach usb->devctrl, successfully gen bitstream vga, usb have both been attached to devctrl
2017-11-25 Fixed ex_mem
    The problem was that it will flush everything when pipline-stoped
    [ex_mem.vhd]
2017-11-26 address mapped fix: addr in kseg1 should minus 0xa0000000
    [mmu.vhd]
2017-11-27 fix bugs related to ebase
    [id.vhd, inst_const.vhd]
2017-12-01 refactor boot_ctrl to pure combinational circuit
2017-12-01 Delete `reset` pin from MMCM
    But I think I have done this before
2017-12-01 Multiple fixes
    - Implemented Status[IM] field
    - Eliminated some "inferring latch" warnings
    - Fixed some bugs in serial_ctrl
    - Re-order interruptions
    [cp0_const.vhd, cp0_reg.vhd, ctrl.vhd, devctrl.vhd, ex.vhd, mem.vhd, mmu.vhd, serial_ctrl.vhd]
2017-12-05 fix fatal error of vga: video_clk not connected
    [thinpad_top.v]
2017-12-07 Fix ex_mem for HI LO registers
    We should update HI LO value when the pipeline isn't stopped to reset it
    back to 0.
    Why there's no problem in the beginning? Because before
    b4cda92227d2651ed69e41523a76fe6c5355189d we are wrongly resetting
    everything
    [ex_mem.vhd]
2017-12-09 fix a bug in ASID field
    [mmu.vhd, mmu_const.vhd]
2017-12-13 fix 2 errors in eth_ctrl.vhd: 1. assign between data of different length 2. miss out 'cmd' 3. busy = '1' even when not writing 4. remove byteSelect_i
    [eth_ctrl.vhd]
2017-12-13 fix small bug in thinpad_top.v
    [thinpad_top.v]
2017-12-17 fix: should have filled dividend into initial buffer
    [div.vhd]
2017-12-18 fix error in id about BREAK & SYNC
    [id.vhd]
2017-12-22 Fixed COUNT register, close #56
    [cp0_reg.vhd]
2017-12-26 Fix eth_ctrl
    - Rewrite time sequence of eth_ctrl
    - Change ethernet address to meet u-boot
    [devctrl.vhd, eth_ctrl.vhd, thinpad_top.v]
2018-01-03 fix what was originally correct
    [devctrl.vhd, thinpad_top.v]
2018-04-08 Unknown instructions for linux (#10)
    close #3
    Squashed commits:
    * ADD TLBINVF and EHB mechanism
    * fix lf/crlf mismatch
    * update xpr file
    * fix code confliction
    * Remove duplicate testcases
    * add new tests into the project file
    * finetune ehb testcase
    * Remove Confliction
    * reset xpr
    * Add sim testcases back
    * isTlbINVF -> CP0SP_TLBINVF
    * remove ismtc0-series signals
    [alu_const.vhd, cp0_const.vhd, cp0_reg.vhd, cpu.vhd, ctrl.vhd, datapath.vhd, ex.vhd, ex_mem.vhd]
2018-04-08 eret doesn't have to be ehb
    [id.vhd]
2018-04-12 addr3 ip core generated; not tested; target device changed
2018-04-20 check led and seg7
2018-04-20 fix voltage setting
2018-04-20 SPI should be disable after one read has done
2018-04-21 add voltage config
2018-04-22 fix flash I/O binding
    [top.xdc]
2018-05-03 fix cross clock region logic
    [ddr3_ctrl.vhd, ddr3_high_throughput_test_top.vhd]
2018-05-12 对流水线中的port进行reorder，并修改了datapath中部分port的顺序使之可以统一
2018-05-12 cp0_config registers specification
    for config 0:
    31: 1
    30-16: zero because we do not need an fixed mapping MMU
    BE: 0(for little endian)
    AT: 0(mips32)
    AR: 0(release 1)
    MT(9:7): 1(because we are standard TLB)
    VI: 0(for instruction cache is not cache)
    K0(2:0): 2 for Uncached and 3 for Cacheable, writing other value will be ignored
    Only bits 2:0, 30:25 can be write(inclusive)
    **we can only write 2 or 3 to 2:0**
    for config1:
    31: 1
    30-25: MMU Size - 1 (001111)
    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
    [ddr3_const.vhd]
2018-05-12 调整了dataoath中cp0port的顺序使之和cp0_reg.vhd中一致。
2018-05-13 fix some misalignments in cp0_config_const
    [cp0_config_const.vhd]
2018-05-16 debugpoint exception
    添加了watchLo和watchHi寄存器及相关的支持，并修改了原有except_const中部分会导致我的modelsim崩溃的代码。
2018-05-16 fix watch and allow deret
    [cp0_const.vhd, cp0_reg.vhd, ctrl.vhd, datapath.vhd, except_const.vhd, id.vhd, inst_const.vhd]
2018-05-21 fix undriven signal `wid` (close #28)
    [ddr3_ctrl_100.vhd]
2018-05-25 Multiple bugfixes
    close #29
    close #30
    [cp0_reg.vhd, ctrl.vhd, datapath.vhd]
2018-05-26 补充watch pending的相关测例
2018-06-23 successfully run linux on thinpad
    1. tlb-invalid & tlb-modified exception
    2. fix serial_ctrl
    3. fix ll/sc error
    4. error related to CP0
    [cp0_reg.vhd, cpu.vhd, ctrl.vhd, datapath.vhd, devctrl.vhd, ex.vhd, ex_mem.vhd, except_const.vhd]
2018-07-03 dual tlb look-up (Linux passed but tests failed)
    [cpu.vhd, devctrl.vhd, fake_ram.vhd, mmu.vhd, tb.vhd, top.vhd]
2018-07-12 add test multicore_boot1 and fix spin address in bootloader
    [boot_ctrl.vhd]
2018-07-12 Fix devctrl
    It should not break a long device access
    [devctrl.vhd]
2018-07-14 fix the BadVAddr=0x0 problem
    [if_id.vhd]
2018-08-22 restore interruptIv1Offset default
2018-08-22 fix line ending of src/div.vhd
    [div.vhd]
2018-08-22 shorten cp0 reset code
    [cp0_reg.vhd]
2018-08-27 fix the logic that keeps delay slot unflushed in id_ex
    [id_ex.vhd]
2018-08-28 keep delay slot not flushed
2018-09-01 switch to enable mem push
